brantemadara-spec/laps/dist/images/assembled.webp

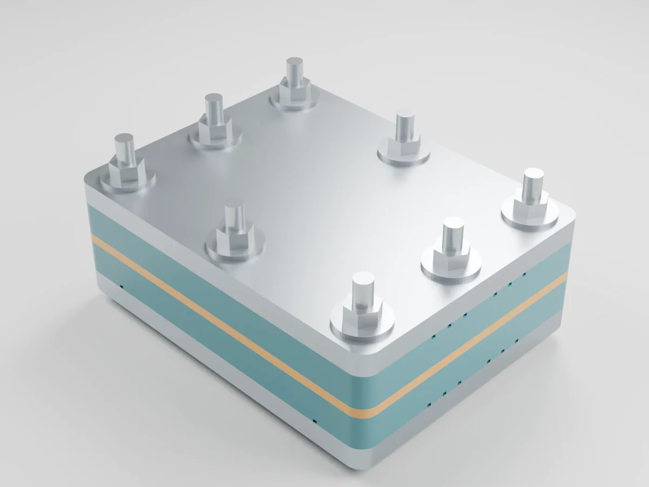
dist/images/assembled.webp
