brantemadara-spec/laps/assets/marle_source/visual/renders/01_assembled_45deg.png

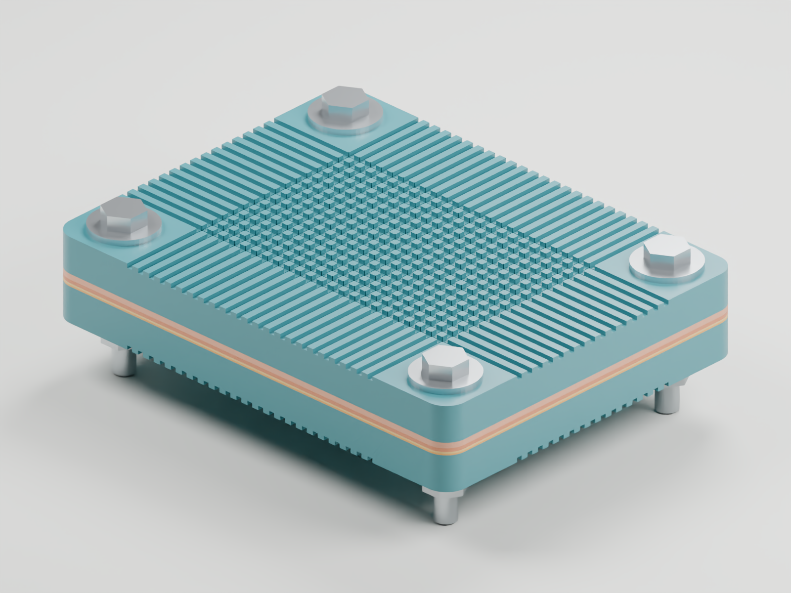
assets/marle_source/visual/renders/01_assembled_45deg.png
