brantemadara-spec/laps/dist/files/LAPS_Pirkumu_saraksts_DEPO_Bergi.pdf

LAPS · DEPO Berģi · cenu pārbaude 2026-10-06 | 1

# LAPS — pirkumu saraksts

DEPO Berģi · Siguldas šoseja 6 · 6. oktobris 2026

DEPO Berģu aktuālās cenas un atlikumus nevarēju tieši apstiprināt. DEPO summas ir sekundāras cenu salīdzinātāja norādes. Citu veikalu piedāvājumi ir alternatīvas, ja vajadzīgo DEPO nevar sagādāt. Pilnam budžetam trūkst plākšņu un sieta tāmes.

# 1. Pamatvariants esošajam 3D modelim

Prece /
daudzums
Precīzs izmērs | Cena un iegādes vieta
8 bultskrūves | M6 × 60; pilna vītne DIN 933; solis 1,0; vēlama klase 8.8 | DEPO cena nav apstiprināta. Delve 2 alternatīva: 10.9 melnas, 10 gab.; 1,36 € ar aprēķinātu 21% PVN.
8 uzgriežņi | M6 DIN 934; atslēga 10 mm; atbilstoša klase | DEPO salīdzinātāja norāde: 100 gab., klase 12.0; 2,11 €.
16 paplāksnes | M6 DIN 9021; Ø6,4 × Ø18 × 1,6; metāla, bez gumijas | DEPO salīdzinātāja norāde: 40 nerūsējošas; 2,62 €.
2 tērauda plāksnes | S235; 130 × 100 × 8; R6; 8 × Ø6,6 katrā | DEPO cena nav apstiprināta. Metāla Alianse: gatavās detaļas pēc tāmes.
2 sieta oderes | 84,5 × 54,5, R3; 304; acs 0,15; stieple 0,10 mm | DEPO cena nav apstiprināta. EuroSitex: maza atgriezuma un markas tāme.
1 PETG spole | Ø1,75 mm; 1 kg; bez CF pildījuma | DEPO cena nav apstiprināta. Filaments.lv eSUN PETG Basic: 14,90 € ar PVN; pakomāts +2,90 €.

Atsauces daļsumma 20,99 € = 1,36 + 2,11 + 2,62 + 14,90. Tā apvieno citu veikalu cenas un neapstiprinātas DEPO norādes. Vēl jāpieskaita gatavās plāksnes, siets, izvēlētā piegāde un rīki. Tā nav visa projekta gala cena.

Delve 2 publiskais iepakojums: 93310M-6X60, 10 gab., 1,12 € bez PVN; ×1,21 → 1,36 €. Atlikums un piegāde nav apstiprināti. Ja DEPO ir vajadzīgās cinkotās 8.8 skrūves, izmanto tās šīs alternatīvas vietā. Melno skrūvju virsmas pēc mitras lietošanas nosusina.

Nepirkt gremdgalvas skrūves, kokskrūves vai daļējas vītnes skrūves, nepārbaudot derīgumu visiem pieciem gredzeniem. Skrūves garumu 60 mm mēra zem galvas.

# 2. Izvēles DEPO vītņstieņa variants

Šis variants aizstāj 8 bultskrūves un 8 uzgriežņus. Paplāksnes paliek 16. Vienu variantu izvēlas visam komplektam; abus nepērk kopā. Modelī un renderos attēlotas oriģinālās 60 mm skrūves.

Pirkt | Izmērs / izmantošana | Sekundāra DEPO norāde
1 vītņstienis | M6 × 1,0; A2; 1000 mm → 8 gab. pa 70 mm | 1,70 €; agrāk indeksēts, aktuālā cena nav apstiprināta.
1 uzgriežņu iep. | M6 DIN 934, nerūsējoši; 40 gab.; izmantot 24 | 2,37 €; Berģu cena un atlikums nav apstiprināti.
1 paplāksņu iep. | M6 DIN 9021, nerūsējošas; 40 gab.; izmantot 16 | 2,62 €; Berģu cena un atlikums nav apstiprināti.

Stiprinājumu atsauces daļsumma 6,69 €; ar PETG 21,59 €. Plāksnes, siets, piegāde un rīki nav iekļauti. Daļsumma ietver agrāk indeksēto vītņstieņa cenu un nav apstiprināts DEPO piedāvājums.

Salikšana

Apakšā uz katra stieņa ir divi savstarpēji nofiksēti uzgriežņi; iekšējais balstās uz paplāksnes pret tērauda plāksni. Augšā ir viena paplāksne un viens uzgrieznis. Apakšējos uzgriežņus savstarpēji noslēdz ar divām atslēgām pirms celulozes pildīšanas. Stieņu grieztos galus novīlē un pārbauda vītnes.

Lielākā komplekta nominālais biezums: 24 + 16 + 5,4 = 45,4 mm. Ar paplāksnēm un trim apmēram 5–5,2 mm uzgriežņiem kopā 63,6–64,2 mm. 70 mm stienis dod vietu vītnes izvirzījumam abos galos; faktisko izmēru pārbauda saliekot. Aizver pakāpeniski pa diagonāli, saudzīgi ar roku. Uzgriežņu pievilkšana nav spiediena mērījums.

Rīki — aizņemties, pirkt tikai trūkstošos

Vajag | Alternatīva, ja DEPO nevar sagādāt | Cena bez piegādes
2 atslēgas 10 mm | REVA CR-V SATIN SA-6314324 | 2 × 1,22 = 2,44 €
1 bīdmērs 0–150 mm | REVA metāla EK-3015 | 5,00 €
1 svari 200 g / 0,01 g | Motivs, kods 132772 | 6,60 €

Rīku kopā 14,04 € pirms piegādes. REVA publicē pieejamību; Motivs publicē 10+, bezmaksas saņemšanu Duntes 56 un pakomātu no 1,90 €. DEPO rīku cenas nav apstiprinātas. Rādījuma solis nav precizitātes garantija.

Izmantot esošu paplāti ≥200 × 150 mm, trauku, masas blenderi/maisītāju un žāvēšanas papīru. Vītņstienim vajag metāla zāģi un vīli. Ja drukas caurumus jāattīra: Ø2 un Ø6,6 mm urbji. Tērauda plāksnes vēlams saņemt jau izgatavotas.

# 3. Plākšņu un sieta izgatavošanas prasības

Tērauda atbalsta plāksnes

2 × S235/S235JR, 130 × 100 × 8 mm, ārējie stūri R6, gludas un plakanas saskares virsmas, visas malas un caurumi bez atskabargām. Katrai 8 caurejoši Ø6,6 mm urbumi bez vītnes. Vienas detaļas masa aptuveni 0,80 kg.

Centri no plāksnes centra, mm | Centri no plāksnes centra, mm
(−53, −38) (0, −38) (53, −38) | (−53, 0) (53, 0)
(−53, 38) (0, 38) (53, 38) | Visu urbumu Ø6,6; detaļas biezums 8 mm

Metāla Alianse: S235 8 mm loksne HRS00076, publiski 90 €/m² un noliktavā; PVN režīms izvilkumā nav skaidrs. 0,026 m² × 90 = 2,34 € ir tikai teorētiska sagatavju laukuma vērtība. Gatavu detaļu cena ietver darba minimumu, griešanu, 16 urbumus, atskabargu noņemšanu un vajadzīgo plakanumu. Nepieciešama tāme ar PVN un piegādi. Pilna 1500 × 6000 mm loksne šim projektam nav vajadzīga, ja piegādātājs izgatavo no sava materiāla.

Metāla Alianse — S235 loksne 8 mm, HRS00076 (https://www.metali.lv/lv/produkti/loksne-karsti-velmeta/8mm-1500x6000)

Metāla Alianse — detaļu griešana un urbšana (https://www.metali.lv/lv/pakalpojumi)

Smalkais siets

Vēlams 304 / 1.4301, vienkārša pinuma siets: acs 0,15 mm (150 µm), stieple 0,10 mm, apmēram 100 mesh. Pasūtāma viena 200 × 150 mm sagatave; no tās izgriež četrus 84,5 × 54,5 mm R3 gabalus, divi ir rezerves. Minimāli 150 × 100 mm sagatave dod divus gabalus.

EuroSitex Latvija piedāvā tehnisko nerūsējošo sietu, bet publiski norāda garumu no 1 m. Precīzās markas atlikums un maza atgriezuma/parauga iespēja jānoskaidro. getwiremesh EU alternatīvai publicēta formula 34 €/m² + 6 € par griezumu: 200 × 150 mm aritmētiski 7,02 € pirms PVN un piegādes. Konkrētā izmēra pieņemšana, atlikums un Latvijas piegādes cena nav apstiprināti. Tas nav gala piedāvājums.

EuroSitex Latvija — nerūsējošais tehniskais siets (https://eurositex.lv/lv/Produkcija/stieples-siets--tehniskais-audums-%28stieple-lidz-1_4-mm%29/16/nerusejosie-stieplu-sieti/78/)

getwiremesh — 0,15 mm acs / 0,10 mm stieple (https://getwiremesh.com/shop/wiremesh-v2a-1501/)

Parasts moskītu siets nav automātisks aizvietotājs. Izmēra saspiesto sieta biezumu. Gredzeni paredz 2 × 0,20 mm; citam sietam faktiskā celulozes sprauga jāpārkalibrē.

Izgatavotājam dotie faili

P03_steel_backer_8mm_1to1.dxf · steel_backer_MAKE_2.step · LAPS_Pulp_Press_Technical_Drawings_RevA.pdf
- P04_mesh_cut_pattern_1to1.dxf · Tames_pieprasijumi_LV.txt. Pirkumu arhīvā tie ir jau pievienoti. Pieprasījuma teksts ir sagatavots, nav nosūtīts.

Ko drukāt

2 PETG plāksnes un pa vienam no pieciem gredzeniem, augstumi 1,4 / 2,4 / 3,4 / 4,4 / 5,4 mm. Gredzens nosaka 1–5 mm mitro spraugu, nevis garantētu sauso biezumu. Visu izdruku CAD masa apmēram 549 g; viena 1 kg spole dod rezervi. eSUN profilam izmanto eSUN ražotāja parametrus.

# 4. Avoti un budžeta aizpildīšana

Pārbaudīts 2026. gada 6. oktobrī. Veikalu publicētie atlikumi nav rezervācija. Neviena alternatīvā veikala lapa neapliecina DEPO Berģu pieejamību.

DEPO veikalu saraksts — Berģi, Siguldas šoseja 6 (https://depo.lv/)

DEPO cenu norādes — sekundārs avots

DEPO uzgriežņu ieraksts cenu salīdzinātājā (https://www.salidzini.lv/click.php?itemid=95754468776&q=uzgrieznis+din+934m-6) — 100 gab.; 2,11 €; Berģu cena nav apstiprināta

DEPO paplāksņu ieraksts cenu salīdzinātājā (https://www.salidzini.lv/click.php?itemid=95755187871&q=papl%C4%81ksnes+din9021+m6) — 40 gab.; 2,62 €; Berģu cena nav apstiprināta

DEPO M6 A2 vītņstieņa cenu salīdzinātāja ieraksti (https://www.salidzini.lv/click.php?itemid=95609168596) — 1000 mm M6 A2; 1,70 € ir agrāk indeksēta norāde

DEPO nerūsējošo M6 uzgriežņu 40 gab. ieraksti (https://www.salidzini.lv/click.php?itemid=95753564220) — 40 gab.; 2,37 €; Berģu cena nav apstiprināta

Citu veikalu pārbaudītās produktu lapas

Delve 2 — DIN 933 pilnas vītnes skrūves, melnas (https://www.delve2.lv/lv/products/screws-with-metric-thread/hexagon-head-bolts-full-thread-black-din-933m/) — 10 gab. M6 × 60, klase 10.9; 1,12 € bez PVN

Filaments.lv — eSUN PETG Basic melns, 1 kg (https://filaments.lv/produkti/esun-petg-basic-melns-filaments-black/) — 14,90 € ar PVN; pakomāts +2,90 €; publicēti 25 gab.

REVA — 10 mm kombinētā atslēga (https://www.reva.lv/sa-6314324-kombineta-atslega-10-mm-cr-v-satin-%28indija%29/1840/1/p) — 1,22 €/gab. ar PVN; vajag 2

REVA — 150 mm metāla bīdmērs (https://www.reva.lv/ek-3015-bidmers-150mm-002mm/1061/1/p) — 5,00 € ar PVN

Motivs — 200 g / 0,01 g svari, 132772 (https://motivs.lv/kabatas-un-juvelierizstradajumu-svari/elektroniskie-juvelierizstradajumu-svari-200g-0-01g-sudraba) — 6,60 €; pakomāts no 1,90 €

Darba faili

LAPS_Pirkumu_budzets.xlsx: zilajās šūnās ievada apstiprināto cenu par iepakojumu. Var labot pērkamo iepakojumu skaitu. Rindu gala summa parādās tikai, kad visas attiecīgā varianta cenas aizpildītas. Nezināmās cenas ir tukšas, nevis 0 €.

LAPS_Pirkumu_saraksts.csv ir vienkārša tabula; Markdown versijā ir plašāki paskaidrojumi. Tāmes teksts un CAD faili ir atsevišķajā pirkumu ZIP un atjaunotajā pilnajā projekta ZIP.

Pamatvariants: atsauces daļsumma 20,99 € + gatavo plākšņu tāme + sieta tāme + izvēlētā piegāde. Vītņstienis: atsauces daļsumma ar PETG 21,59 € + tie paši iztrūkstošie izdevumi. Izvēles rīki 14,04 € pirms piegādes. Gala budžets pašlaik nav apstiprināts.

Skrūvju klase un paplāksnes nerada zināmu celulozes spiedienu. Formas aizvēršanai lieto roku spēku; spiediena pētījumos izmanto skolas izmērīta spēka presi un projekta eksperimentu rokasgrāmatu.
