brantemadara-spec/laps/assets/marle_source/procurement/LAPS_Marle_Iepirkums_DEPO_Bergi_LV.pdf

LAPS Marle · Rev C · cenas pārbaudītas 07.10.2026. | 1

# LAPS Marle

## Rev C · jaunais pirkumu saraksts

Četri stūra stiprinājumi, noņemams vāks, divas 10 mm PETG plāksnes un kokvilnas marle kartītes abās pusēs. Šis saraksts aizstāj iepriekšējā sieta/eņģes varianta iepirkumu.

Prioritāte: DEPO Berģi, Siguldas šoseja 6. Oficiālā veikala adrese. (https://depo.lv/) Cenas pārbaudītas 2026. gada 7. oktobrī.

Kas jāņem | Daudzums | Precīza specifikācija
Pilnas vītnes metāla skrūve | 4 gab. | M6 × 40 mm, solis 1,0 mm; DIN 933 / ISO 4017; sešstūra galva. Cinkots 8.8 vai atbilstošs nerūsējošs variants.
Sešstūra uzgrieznis | 4 gab. | M6, solis 1,0 mm, DIN 934; 10 mm atslēga.
Platā metāla paplāksne | 8 gab. | M6 DIN 9021; Ø6,4 / Ø18 × 1,6 mm; pa vienai zem katras galvas un uzgriežņa. Bez gumijas.
Parasta kokvilnas marle | 1 iepakojums | 100% kokvilna, neimpregnēta; piem., 90 cm × 1 m. Izgriež 2 loksnes 84,5 × 54,5 mm, R3; pa vienai gludai kārtai katrā pusē.
PETG filaments, ja vajadzīgs | 1 spole | Ø1,75 mm, 1 kg; parasts PETG bez CF pildījuma. Esošo piemēroto materiālu var izmantot.

## Kas no iepriekšējā saraksta izņemts

Divas tērauda atbalsta plāksnes; visa eņģe un tās M4 stiprinājumi; smalkais poliestera siets. M6×60 skrūves jaunpirkumā aizstātas ar M6×40. M6 uzgriežņus, platās paplāksnes un piemērotu PETG var izmantot no esošā komplekta.

DEPO cena un Berģu atlikums nav apstiprināti. DEPO Online pārlūkošanas pārbaudē neatdeva nolasāmu produktu katalogu. Tas nenozīmē, ka preču veikalā nav. Veikalā jāmeklē tieši tabulā dotie izmēri, un pirkuma cena jāieraksta čekā balstītajā projekta tāmē.

# Pārbaudītas cenu alternatīvas

Izmanto, ja vajadzīgo preci nevar iegādāties DEPO. Šīs ir citu pārdevēju interneta cenas, un tās neapliecina DEPO Berģu cenu vai krājumu. Piegāde nav iekļauta. Nepērk vairākus alternatīvos skrūvju komplektus vienlaikus.

Pārdevējs / detaļa | Iepakojums un pirkuma cena | Vajadzīgo detaļu vērtība
Delve 2: M6×40 A2 DIN 933 933A2-6X40 | 20 gab.; 2,60 € bez PVN → 3,15 € ar 21% PVN | 4 gab. ≈ 0,63 €
Delve 2: M6×40 8.8 ZN DIN 933 FOR-933-6X40 | 200 gab.; 12,80 € bez PVN → 15,49 € ar 21% PVN | 4 gab. ≈ 0,31 €
Delve 2: M6×40 10.9 melna DIN 933 93310M-6X40 | 10 gab.; 0,88 € bez PVN → 1,06 € ar 21% PVN | 4 gab. ≈ 0,43 €
INSERV: M6 DIN 934 ESSVE 61068525 | 100 gab.; 4,40 € ar PVN | 4 gab. ≈ 0,18 €
INSERV: M6 DIN 9021 ESSVE 61068297 | 100 gab.; 4,70 € ar PVN | 8 gab. ≈ 0,38 €
BENU: MEDRULL marle 100% kokvilna, 90 cm × 1 m | 1 iep.; 1,09 € attēlotā cena | Formai 2 izgriezumi; atlikums turpmākiem testiem
Filaments.lv: eSUN PETG Basic Ø1,75 mm, 1 kg, melns | 1 spole; 14,90 € ar PVN | Galīgais patēriņš pēc slicera; esošo spoli var lietot

Cena par vajadzīgo skaitu ir materiālu patēriņa vērtība, nevis summa, par kuru var nopirkt iepakojumu. Piemēram, četri A2 stiprinājumi patērē ap 0,63 €, bet pārdevēja 20 gabalu iepakojums maksā aprēķinātos 3,15 €.

Vienas izvēles piemērs: A2 skrūvju iepakojums + INSERV uzgriežņu un paplāksņu iepakojumi + BENU marle = 13,34 € par pilniem iepakojumiem, pirms piegādes. Ja vajadzīga arī jauna PETG spole, šo pašu iepakojumu summa ir 28,24 €. Tā nav DEPO tāme vai viena veikala pirkums.

Delve 2 precīzs noliktavas atlikums nav publicēts; tā noteikumi nosaka cenu bez PVN, šeit gala summa aprēķināta ar 21%. INSERV abiem produktiem norādītas 5 darba dienas, nevis tūlītējs atlikums. BENU piedāvā pirkšanu internetā; konkrētas aptiekas krājums nav verificēts. Filaments.lv produkta lapā norādīti 25 gab. uz vietas; pakomāts Latvijā 2,90 €, saņemšana Kalnciema ielā 148 bez maksas.

# Izmēri, marle un avoti

## Kāpēc jaunā skrūve ir M6×40

Maksimālais salikums no skrūves galvas līdz uzgriežņa ārpusei: 2 × 10 mm PETG + 5 mm starpliku summa + 0,8 mm kalibrācijas pamatstarplika + 2 × 1,6 mm paplāksnes + 5,2 mm uzgrieznis = 34,2 mm. M6×40 dod 5,8 mm vītnes izvirzījumu; garumu mēra zem galvas. 35 mm nav universālais izmērs šim maksimālajam salikumam.

## Marle maina biezuma kalibrāciju

Medicīniskā marle ir lēts izmēģinājuma audums, nevis precīzs 100–200 µm filtrs. Tās atvērumi un šķiedru aizturēšana jāpārbauda ar īsto papīra/lapu masu. Pirms darba marli izskalo tīrā ūdenī un novieto vienā gludā, nesalocītā kārtā. Brīvas apgrieztās šķiedras noņem, nelīmējot un neapšujot malu preses spraugā.

Modelī izmantotais 0,2 mm saspiestais marles biezums katrā pusē ir pieņēmums. Izmēra abas samitrinātās un saspiestās loksnes kopā. Izvēlas vienu pamatstarpliku 0,2 / 0,4 / 0,6 / 0,8 mm, kas atbilst izmērītajai auduma summai, un pievieno vēlamo mitrās masas starpliku summu. Formulas: mitrā sprauga = visu starpliku biezums − abu marļu saspiestais biezums. Pamatstarplikas nesakrauj kā četras obligātas detaļas.

## Nemainīgi nepieciešamās lietas

Divas 10 mm atslēgas, bīdmērs vai skolas mikrometrs, šķēres, ūdens savākšanas paplāte un svari izmēģinājumiem. Izmanto esošos rīkus vai aizņemies skolā. Plānāks PETG salikums bez tērauda nav validēta augstas slodzes prese; paplāksnes izkliedē tikai vietējo skrūvju slodzi. Pievilkšanas moments nenosaka masu nospiešanas spēku.

## Tiešie cenu un specifikāciju avoti

DEPO veikala adrese un Online (https://depo.lv/)

Delve 2 — M6×40 A2, 20 gab. (https://www.delve2.lv/lv/products/screws-with-metric-thread/hexagon-head-bolts-full-thread-stainless-steel-din-933ss/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)

Delve 2 — M6×40 8.8 ZN, 200 gab. (https://www.delve2.lv/lv/products/screws-with-metric-thread/hexagon-head-bolts-full-thread-zinc-palted-din-933zn/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)

Delve 2 — M6×40 10.9 melna, 10 gab. (https://www.delve2.lv/lv/products/screws-with-metric-thread/hexagon-head-bolts-full-thread-black-din-933m/)

Delve 2 — cenu PVN un krājumu noteikumi (https://www.delve2.lv/lv/info/terms-conditions/)

INSERV — M6 DIN934 uzgriežņi (https://www.inserv.lv/products/80791/din934-uzgrieznis-m6-fzb-100gab-essbox-61068525-essve)

INSERV — M6 DIN9021 6,4/18×1,6 (https://www.inserv.lv/products/80804/paplaksne-din9021-m6-fzb-100gab-essbox-61068297-essve)

INSERV — cenas ietver 21% PVN (https://www.inserv.lv/info/noteikumi)

BENU — MEDRULL marle 90 cm×1 m (https://www.benu.lv/p/medrull-marle-nesterila-90cmx1m)

Filaments.lv — eSUN PETG Basic 1 kg (https://filaments.lv/produkti/esun-petg-basic-melns-filaments-black/)

Iepriekš atrastās Salīdzini DEPO uzgriežņu un paplāksņu atsauces ir sekundāras. Atšķirīgas keša cenas neizmantoju kā DEPO tāmi; tās saglabātas tikai izpētes JSON. Pasūtījumi nav veikti, pārdevēji nav kontaktēti.
