brantemadara-spec/laps/PROJECT_DESTINATION.md

# LAPS project destination

Existing public Site: https://laps.dashulyaashsxb.chatgpt.site
Existing project ID: appgprj_6ac538346a088191976e30d51e90588b

This handoff is based on saved Site version 8, source commit
028185700c22cf091a5f689942a47965b97c4a25 (exported 2026-11-09).
The card press is Marle Rev C at / and /laps-siets/.
The pot mold is V4.1 at /podins/; Rev A is a historical archive at /arhivs/.

The local checkout path is not fixed. Serve dist/ as the web root.
Preserve the existing Site/URL for authorized future updates.
The hosting manifest is metadata, not a deployment credential. Access to the
existing Site must be granted by its owner through the hosting service.
No recurring update job is configured. This export does not change the live Site.

See README_SAKT_SEIT_LV.md and DEVELOPER_HANDOFF.md for development instructions.
The old destination note is retained in handoff/ for provenance.
