brantemadara-spec/laps/handoff/ORIGINAL_PROJECT_DESTINATION.md

# LAPS publication destination

Publish every authorized LAPS project update to the same existing Site:
- project_id: appgprj_6ac538346a088191976e30d51e90588b
- public URL: https://laps.dashulyaashsxb.chatgpt.site
- public label: laps
- source checkout: /workspace/laps-site
- current LAPS Marle Rev C at / and the preserved /laps-siets/ route
- pot prototype V4 Blender code, 9-part model and measured geometry review at /podins/; source uploaded 19.10.2026
- previous Rev A documents and design in the marked /arhivs/ archive

The user requested a permanent destination for all project changes; preserve this Site and URL. Do not create replacement Sites. This is a default for future edits, not a configured periodic background update.

Requested laps.zpd.chatgpt.site was rejected by Sites as a Sites-owned custom hostname. The workspace URL segment cannot be changed by the available Site tools. Shortened the same Site label to laps instead.
