brantemadara-spec/laps/dist/files/Laps.pdf

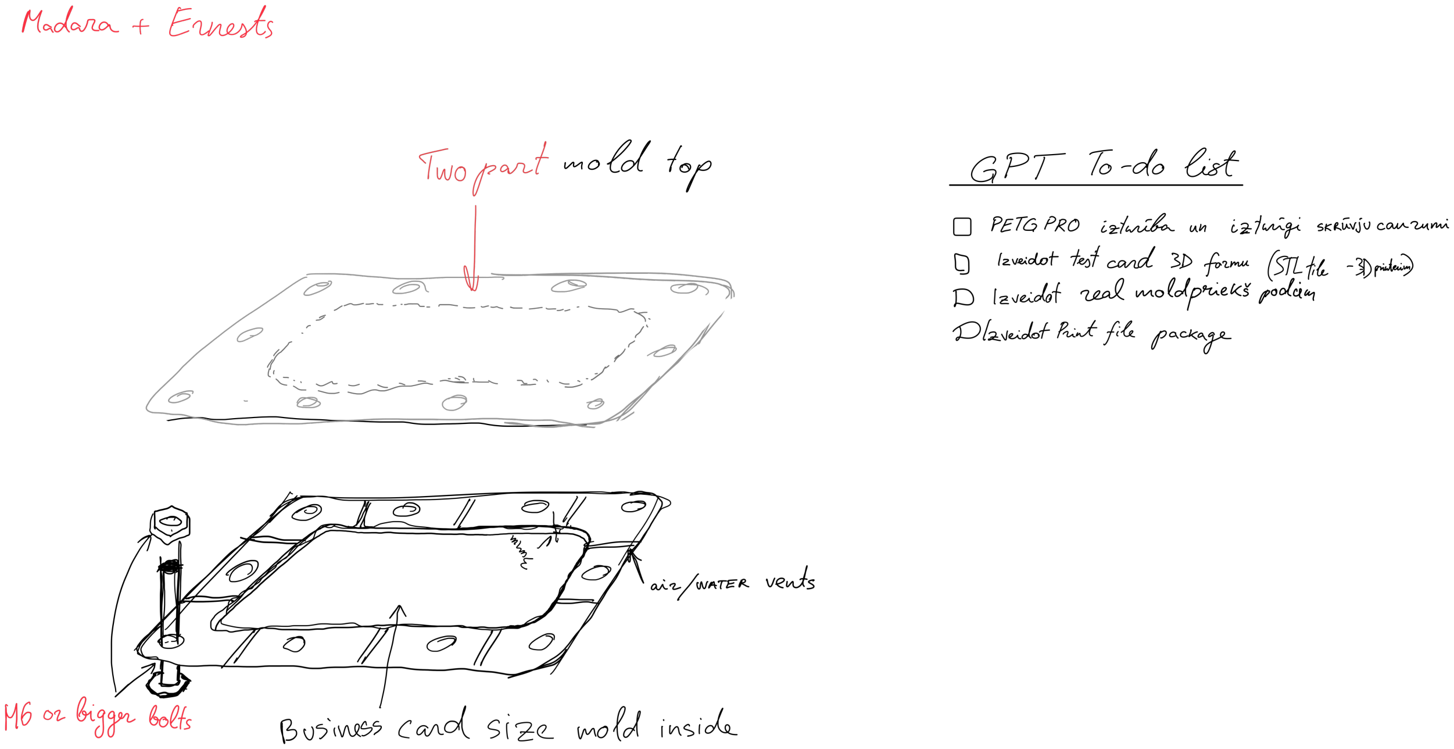
[picture p7: page 1]
