brantemadara-spec/laps/assets/marle_source/docs/web_pages/page-01.webp

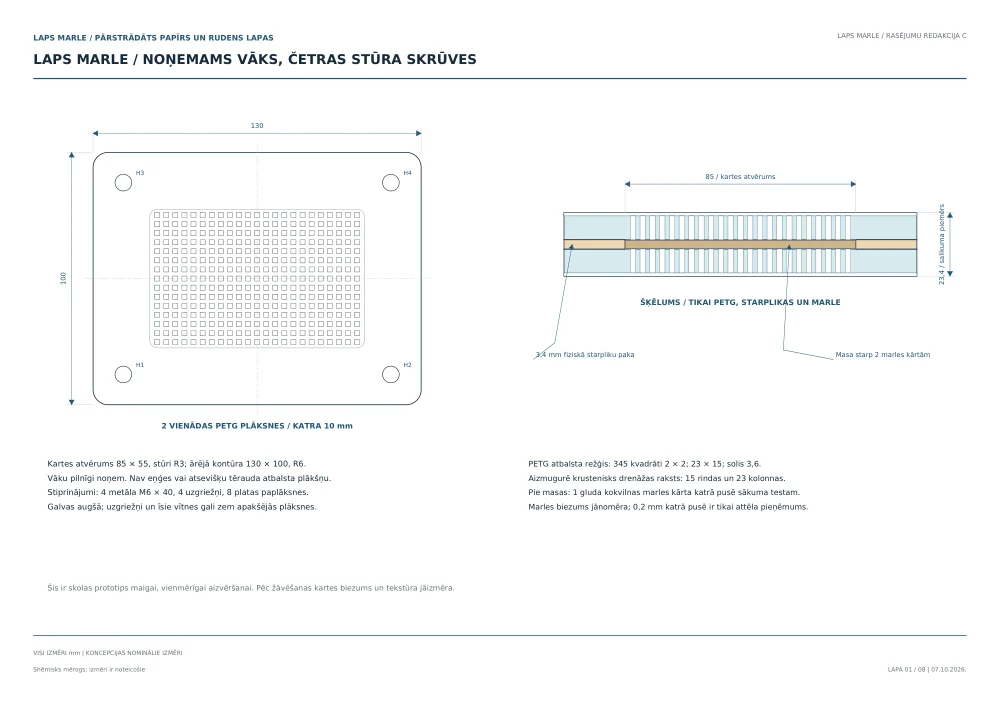
assets/marle_source/docs/web_pages/page-01.webp
