brantemadara-spec/laps/assets/marle_source/docs/web_pages/page-04.webp

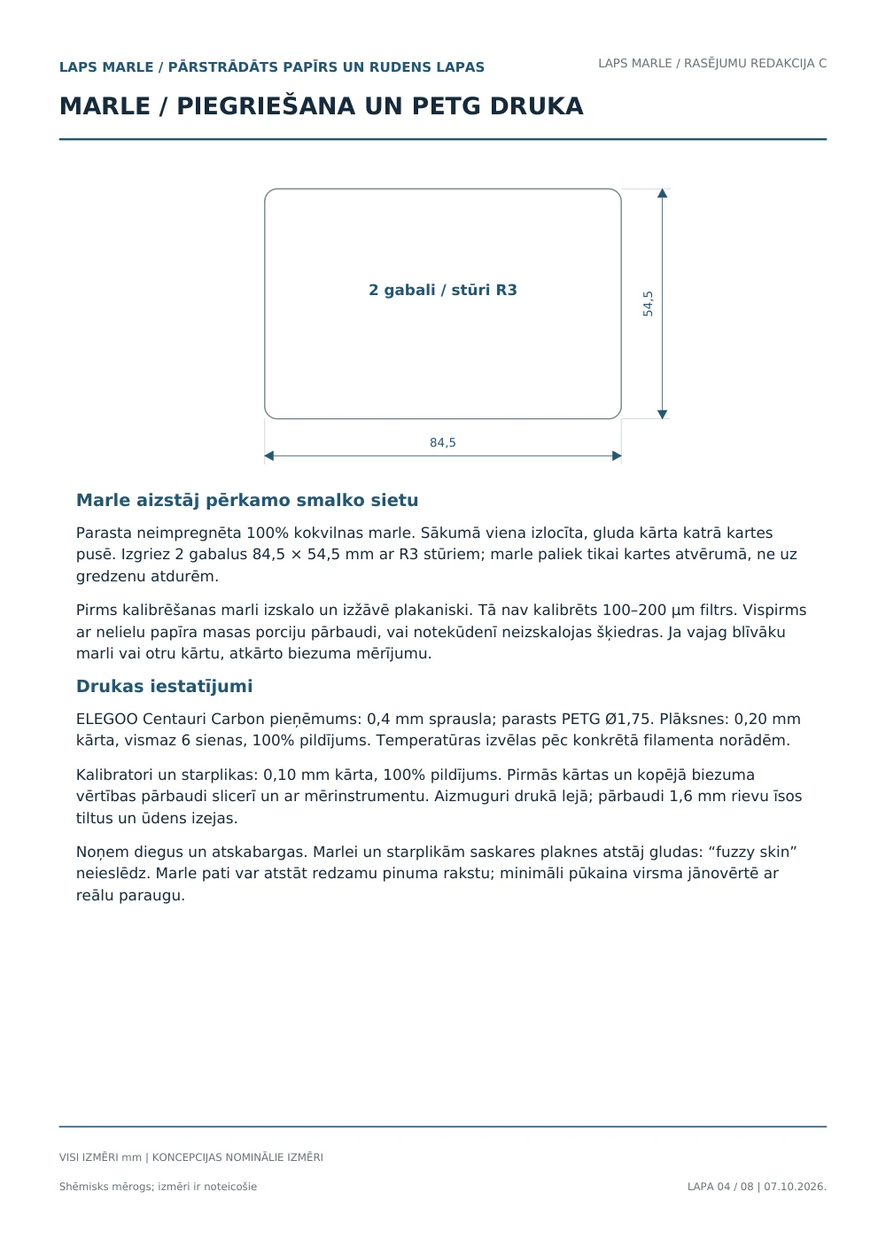
assets/marle_source/docs/web_pages/page-04.webp
