brantemadara-spec/laps/assets/marle_source/docs/web_pages/page-05.webp

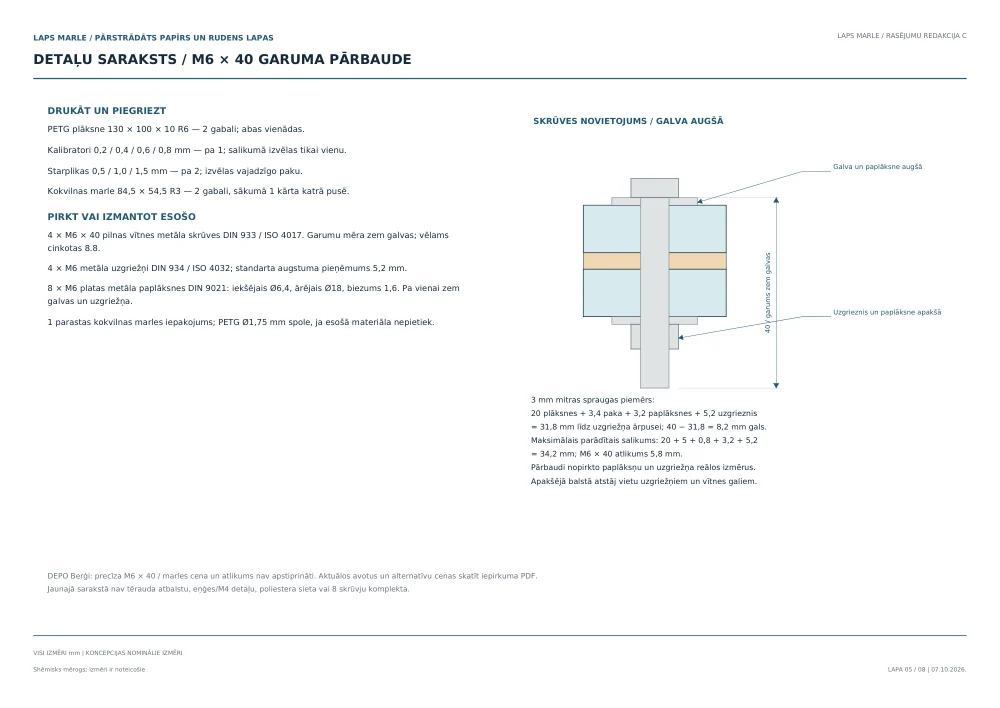
assets/marle_source/docs/web_pages/page-05.webp
