brantemadara-spec/laps/assets/marle_source/docs/web_pages/page-07.webp

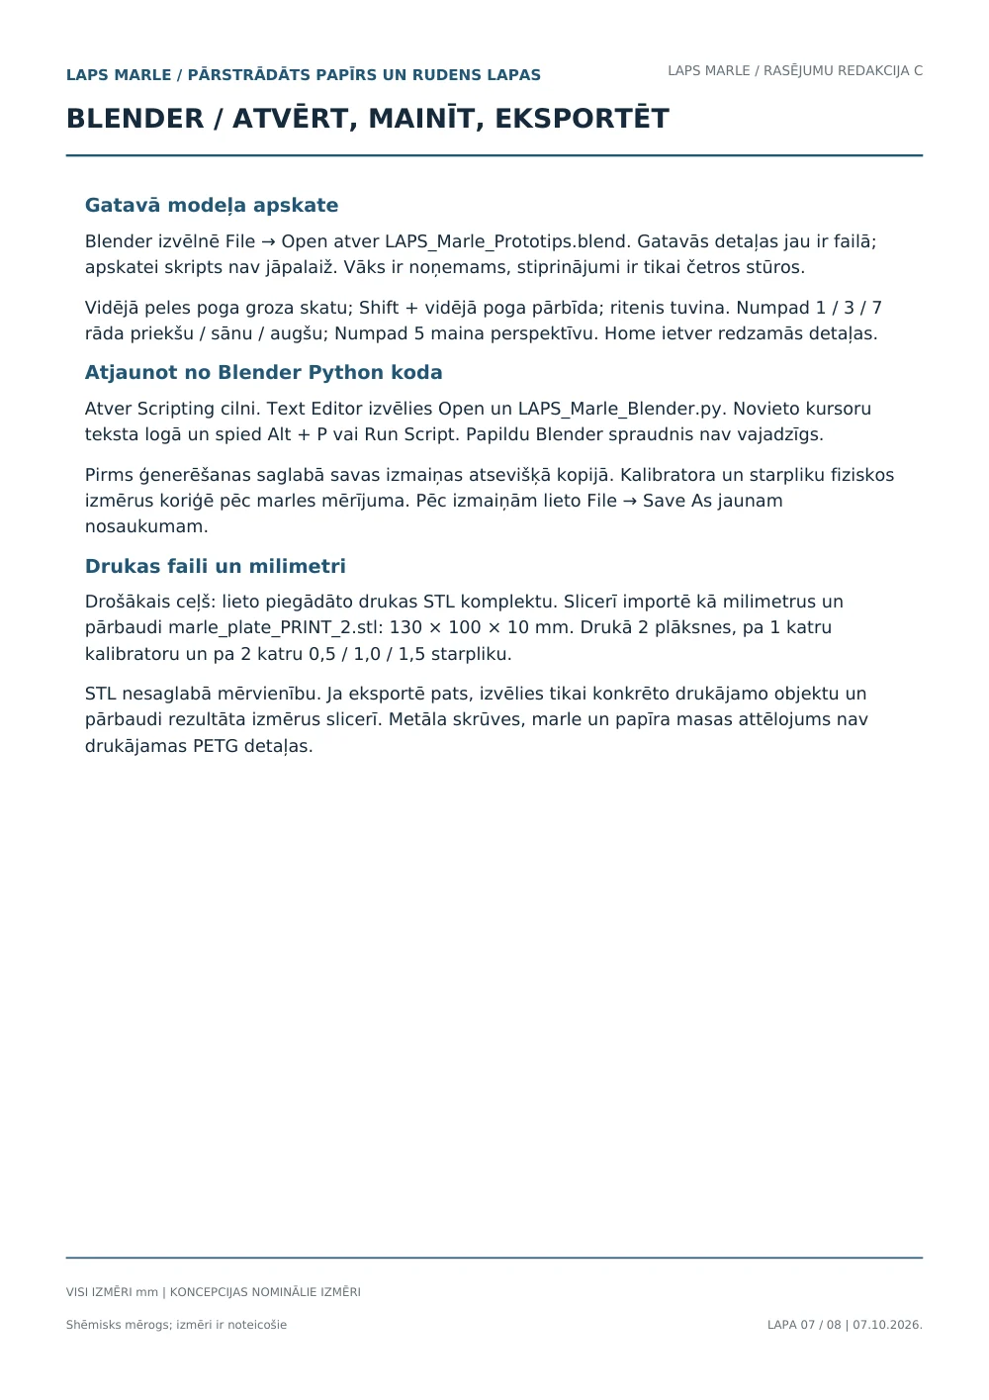
assets/marle_source/docs/web_pages/page-07.webp
