brantemadara-spec/laps/assets/marle_source/visual/renders/03_grid_and_gauze_detail.png

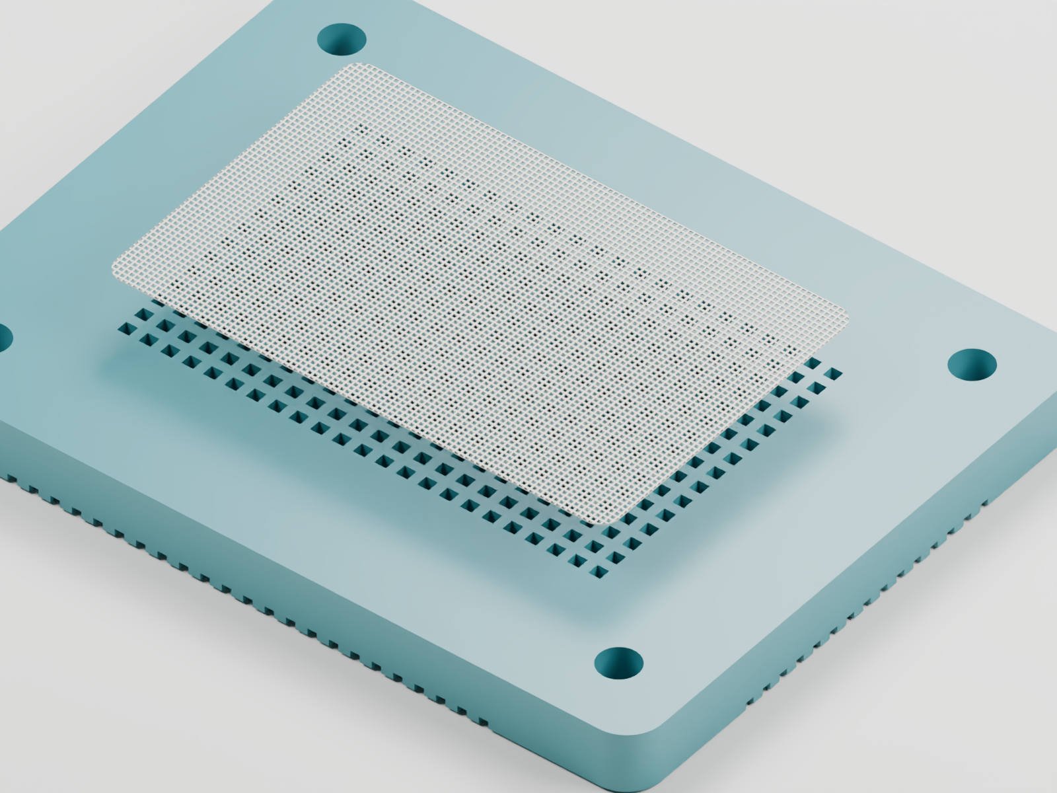
assets/marle_source/visual/renders/03_grid_and_gauze_detail.png
