brantemadara-spec/laps/dist/documents/pages/blender-01.webp

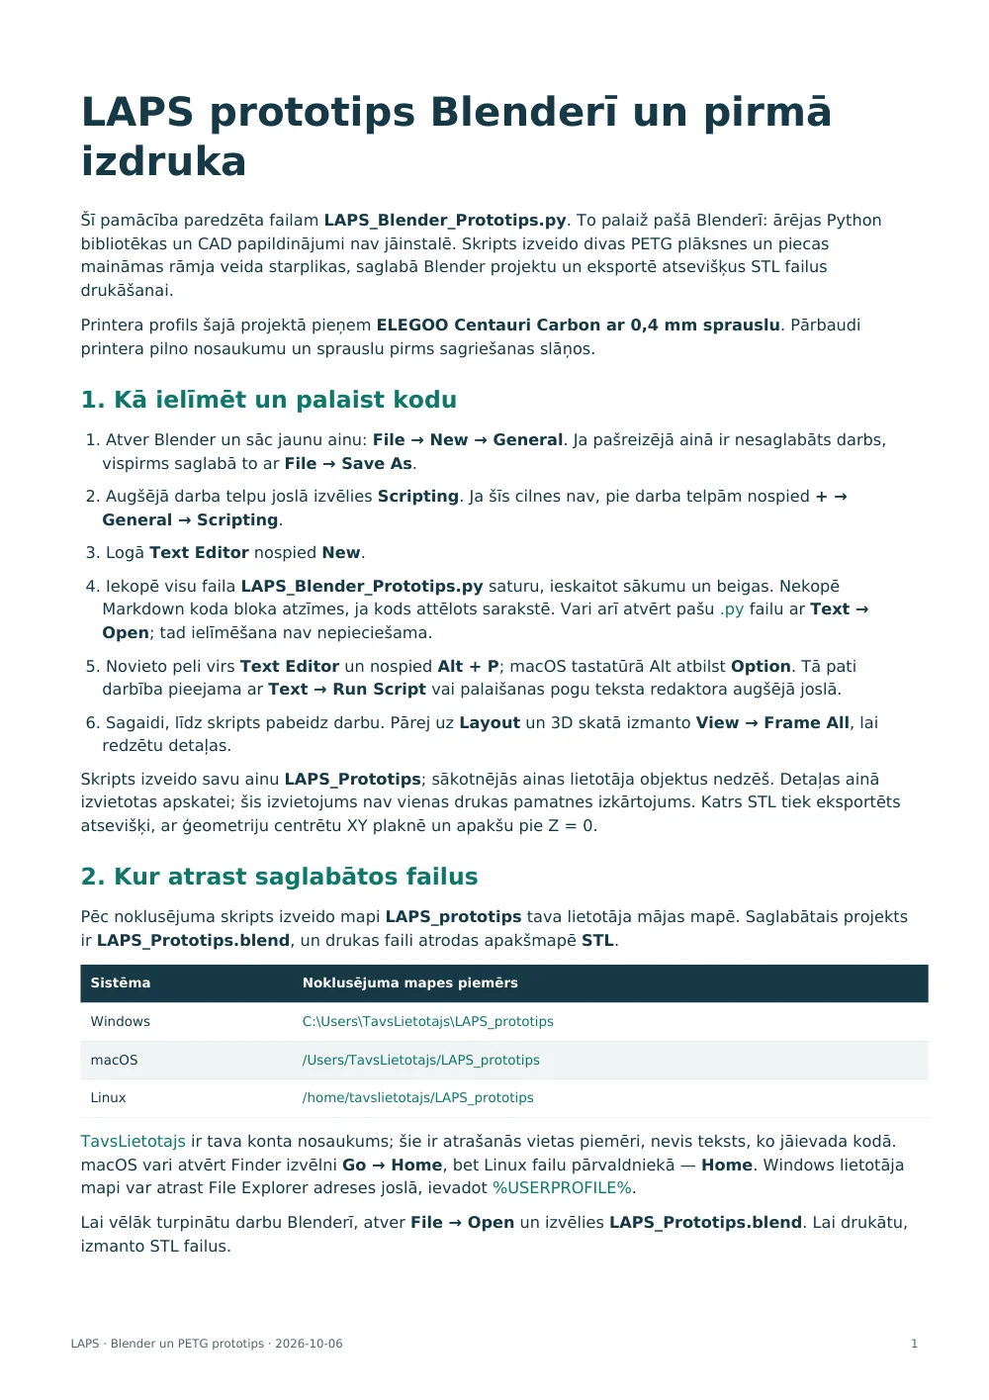
dist/documents/pages/blender-01.webp
