brantemadara-spec/laps/dist/documents/pages/blender-02.webp

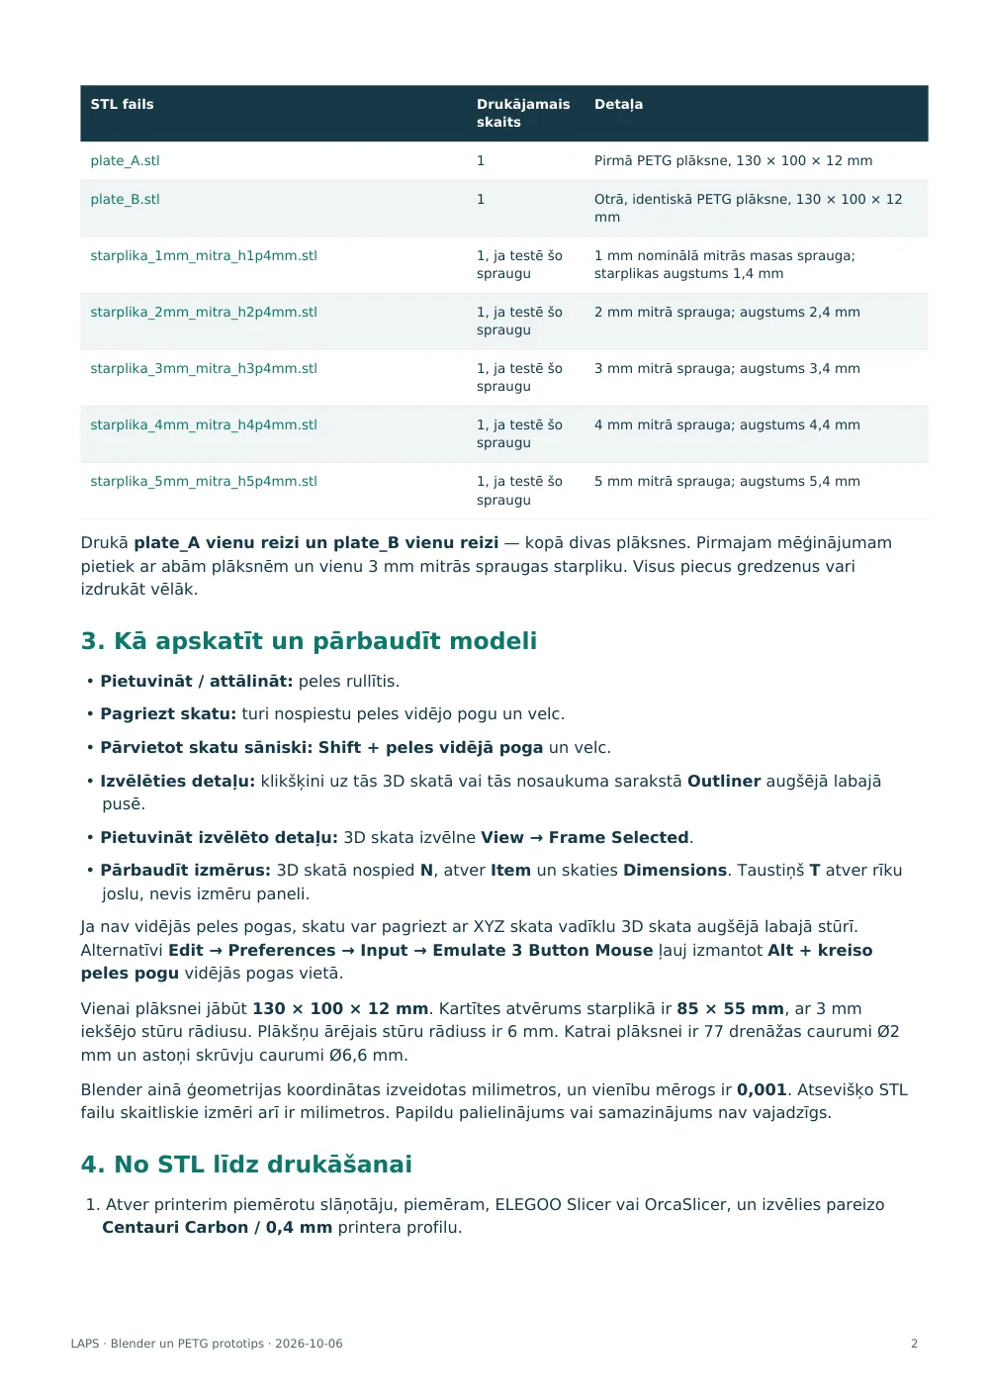
dist/documents/pages/blender-02.webp
