brantemadara-spec/laps/dist/documents/pages/blender-03.webp

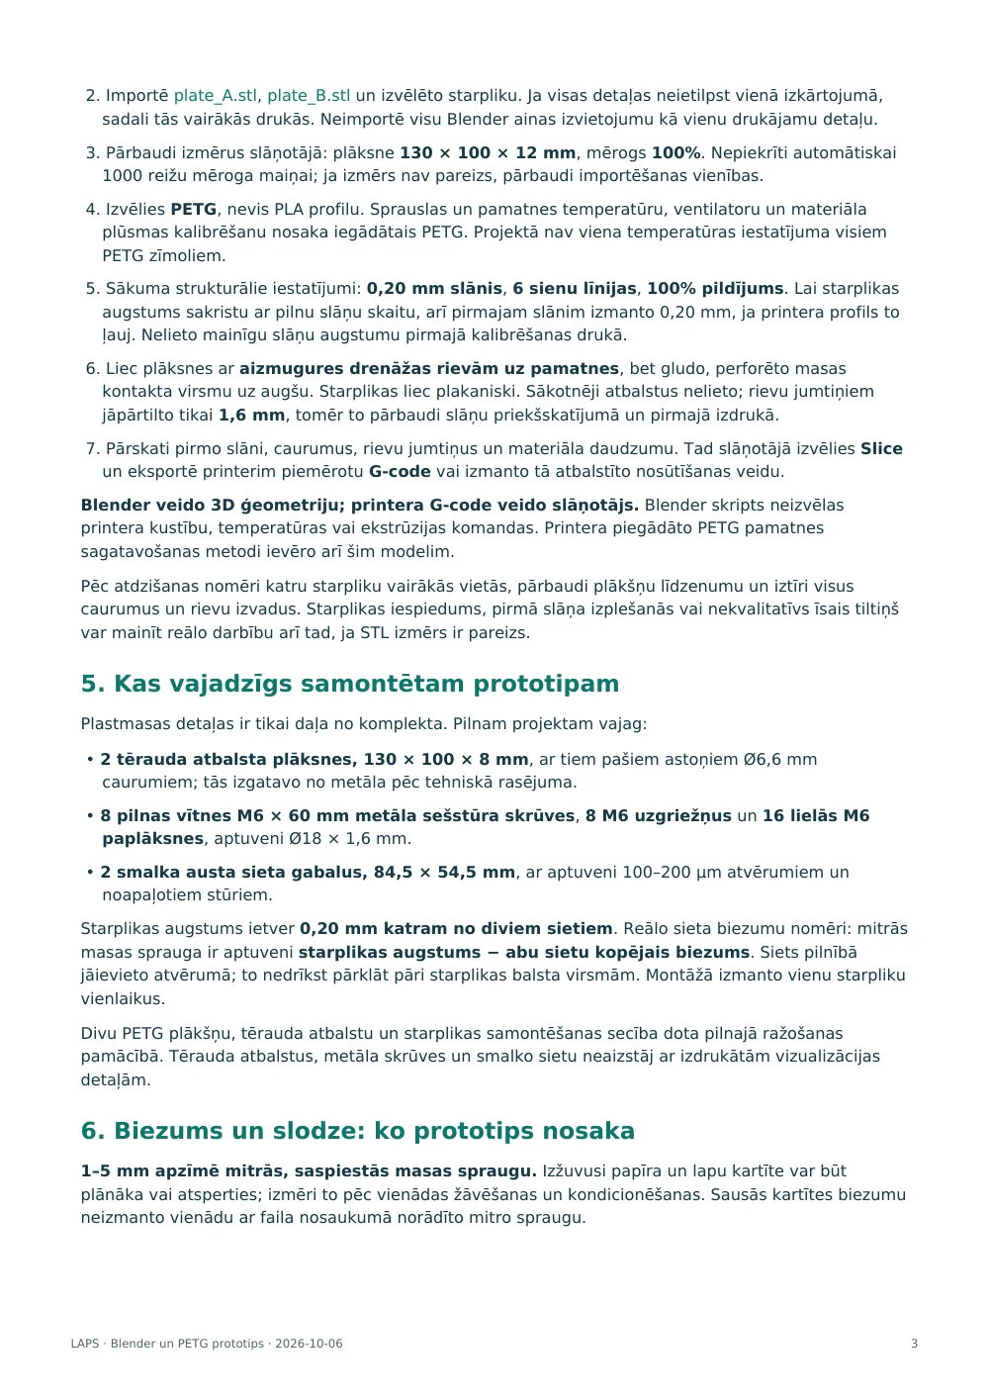
dist/documents/pages/blender-03.webp
