brantemadara-spec/laps/dist/documents/pages/blender-04.webp

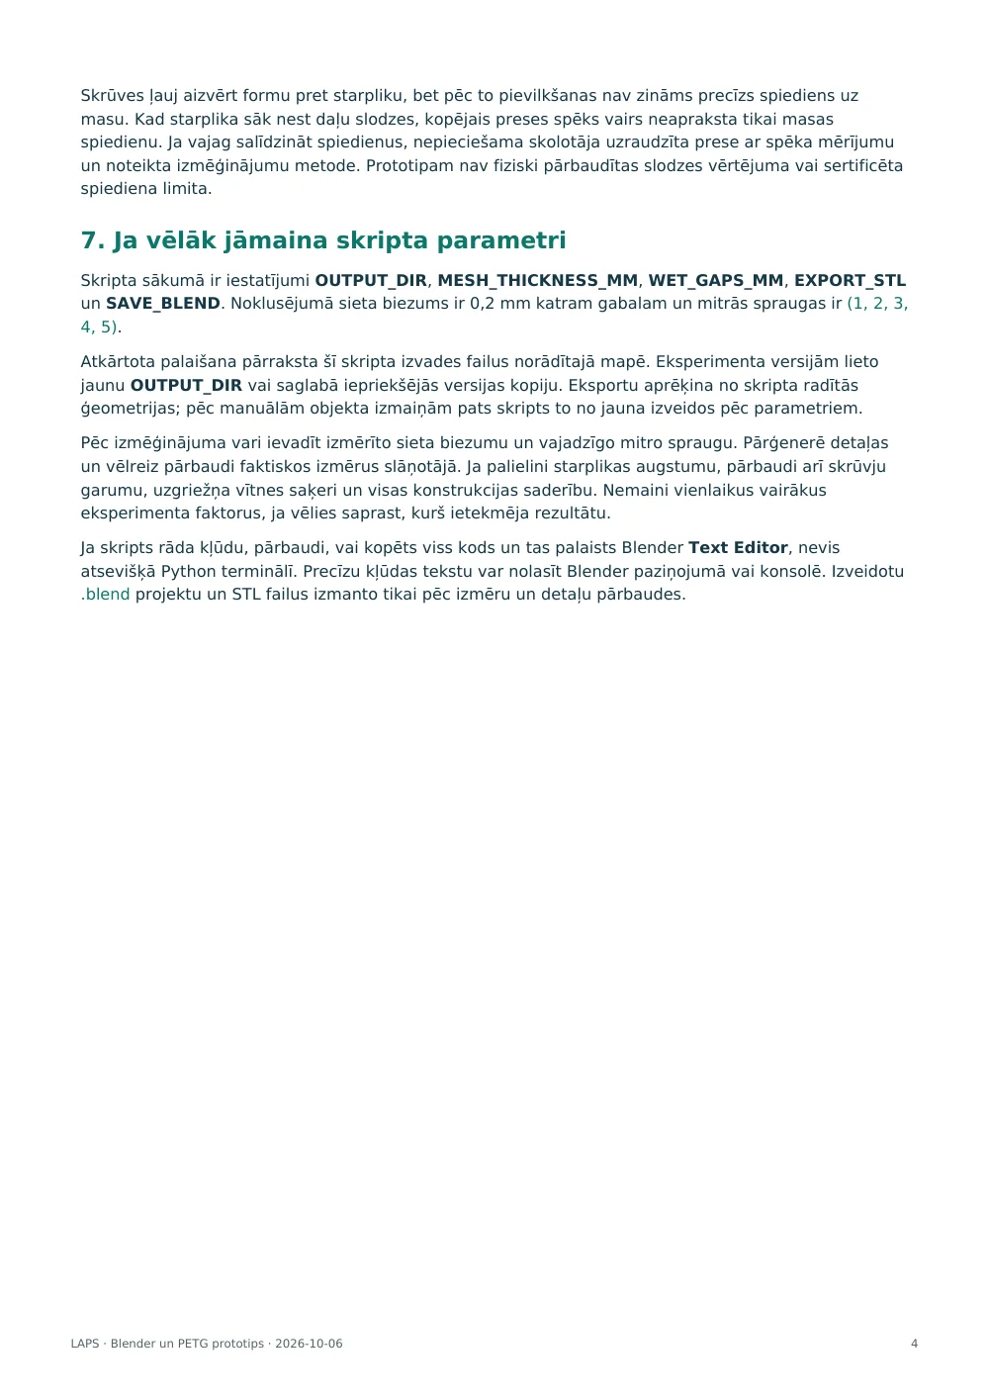
dist/documents/pages/blender-04.webp
