brantemadara-spec/laps/dist/documents/pages/iepirkums-01.webp

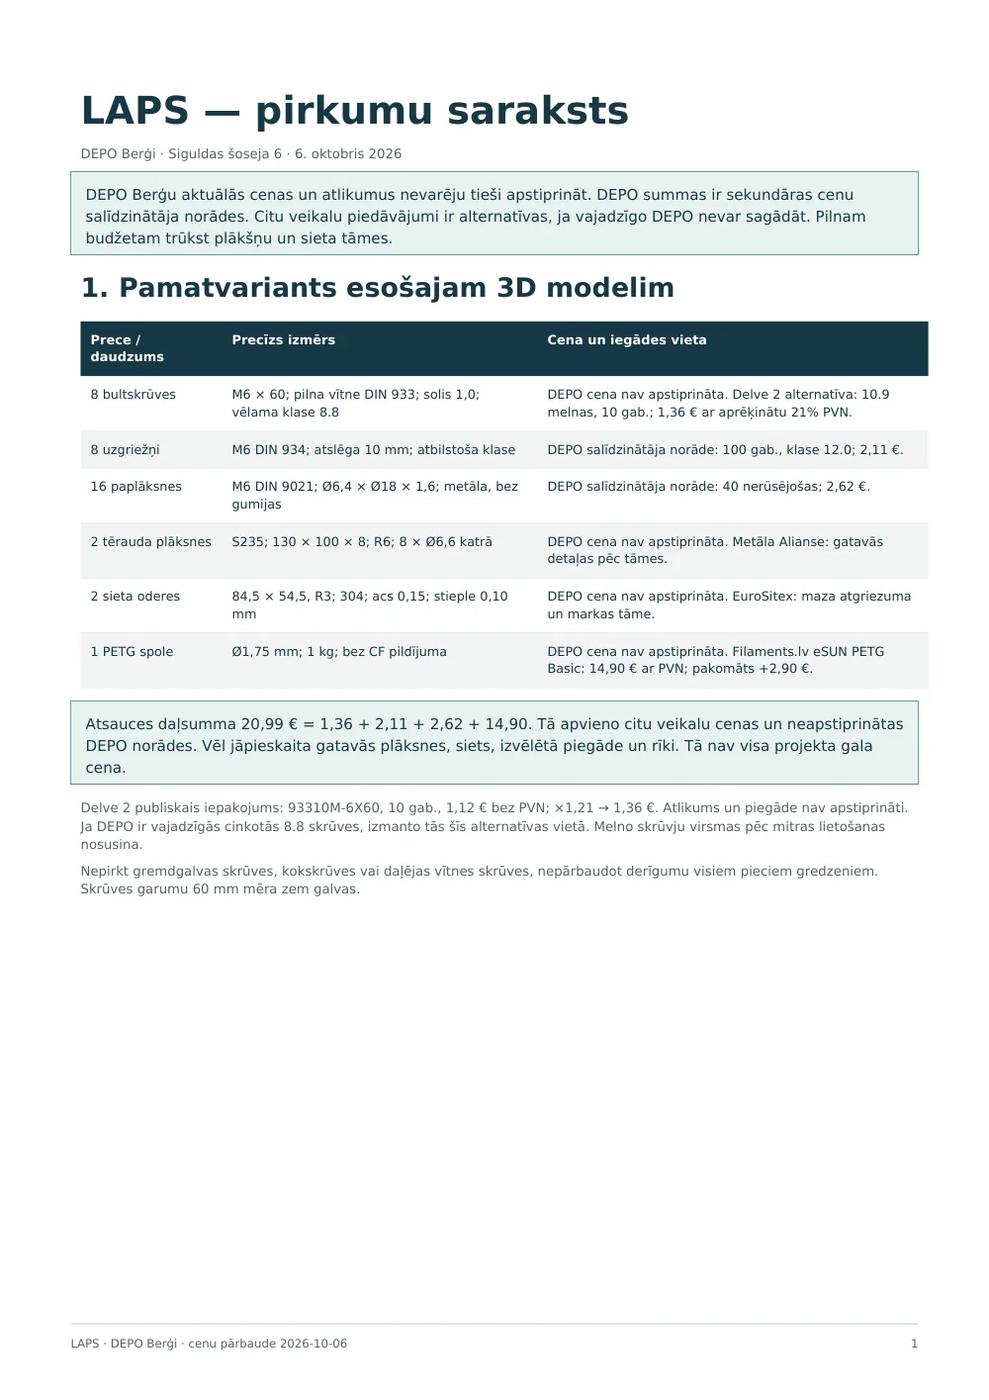
dist/documents/pages/iepirkums-01.webp
