brantemadara-spec/laps/dist/documents/pages/iepirkums-02.webp

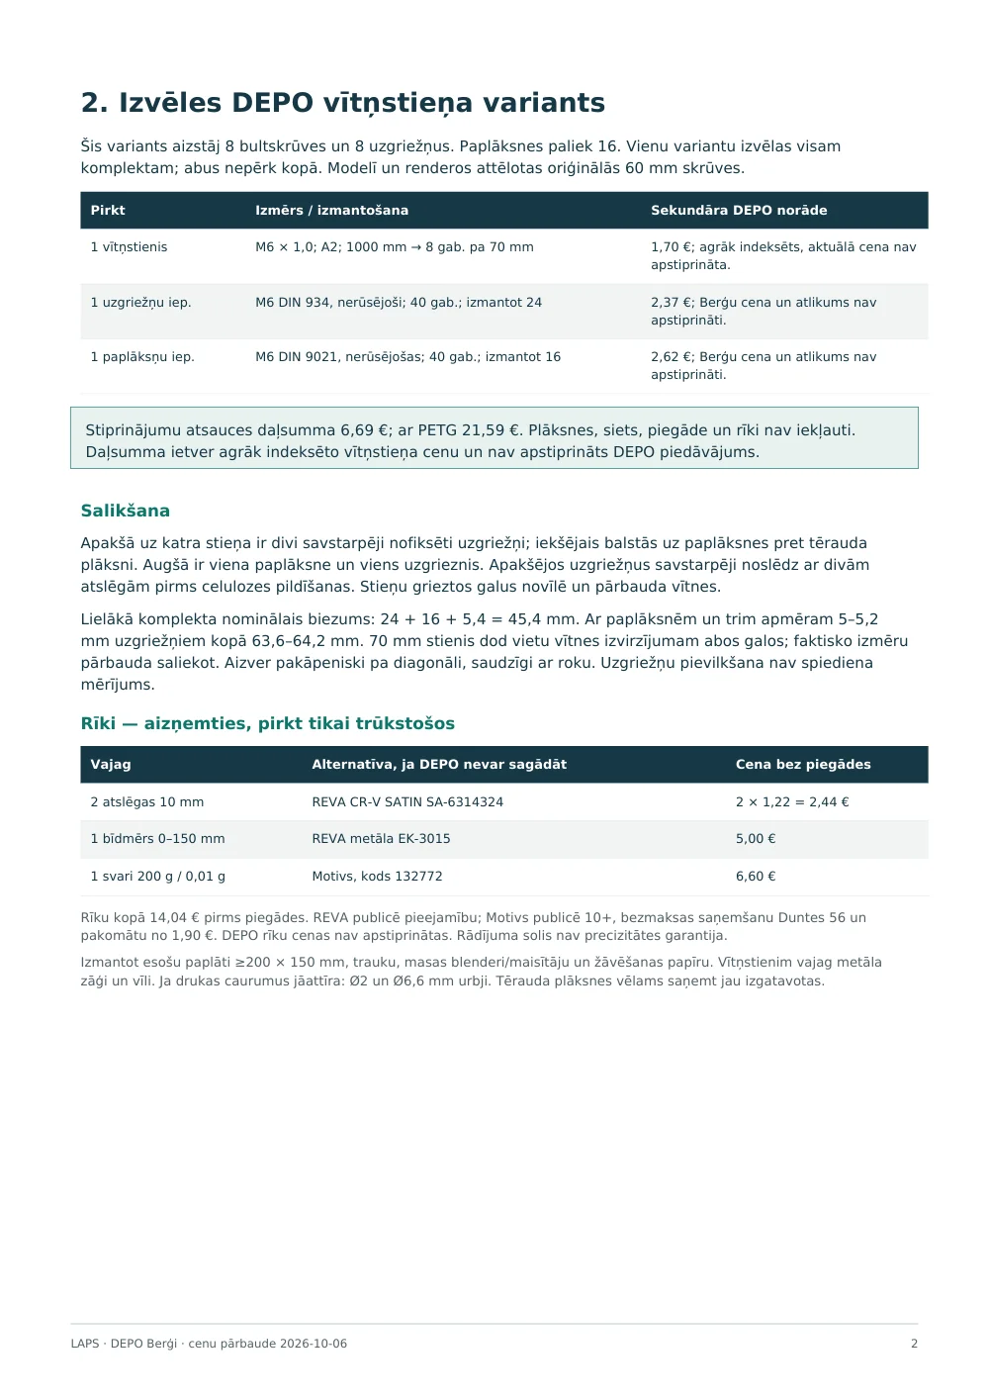
dist/documents/pages/iepirkums-02.webp
