brantemadara-spec/laps/dist/documents/pages/iepirkums-03.webp

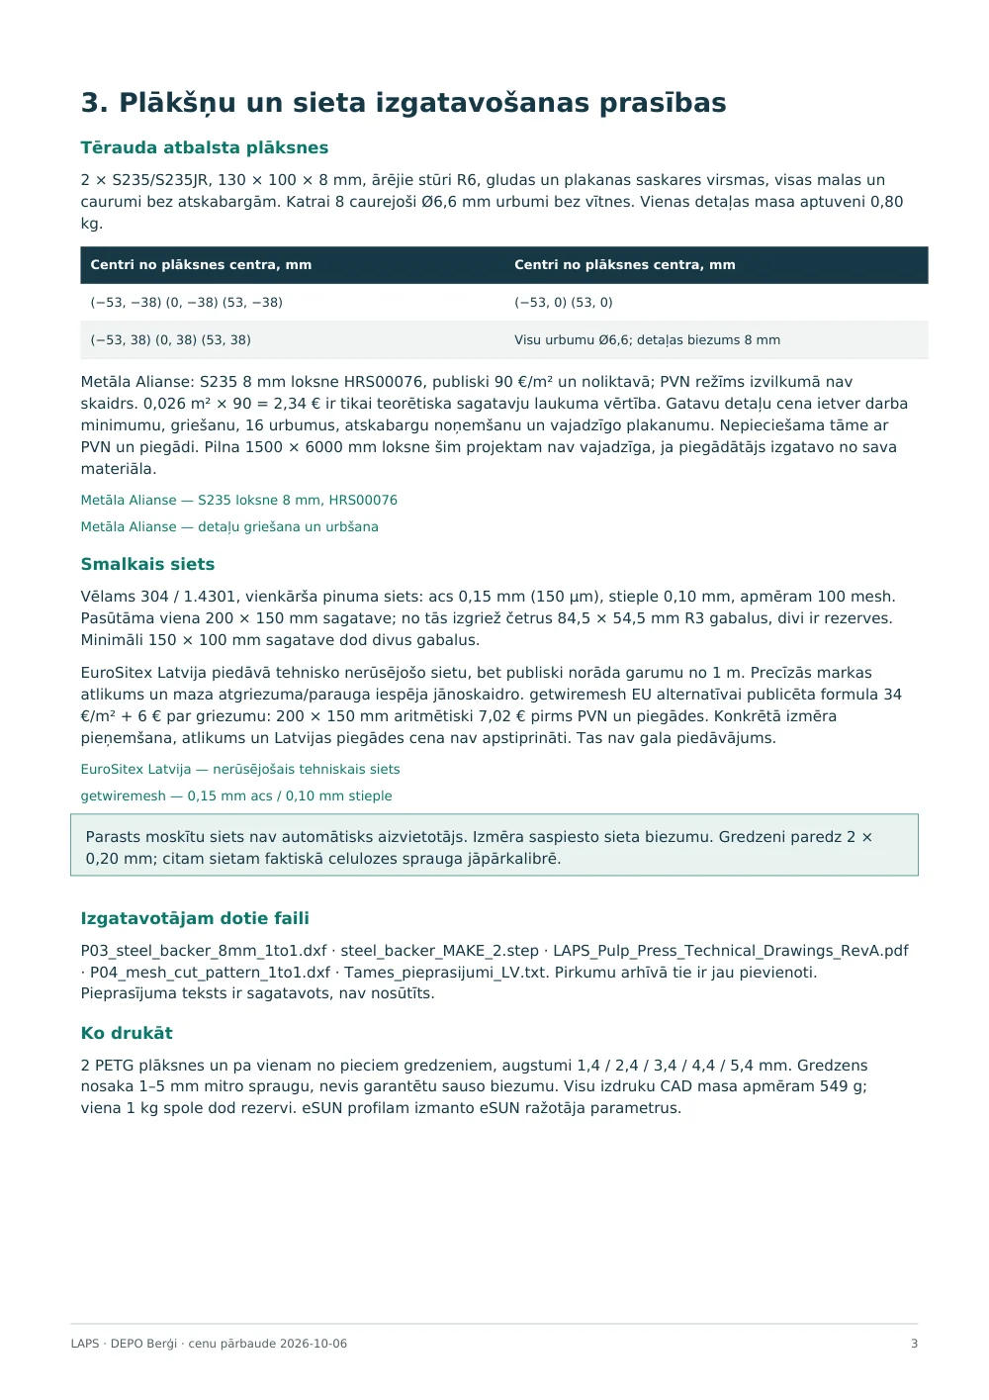
dist/documents/pages/iepirkums-03.webp
