brantemadara-spec/laps/dist/documents/pages/iepirkums-04.webp

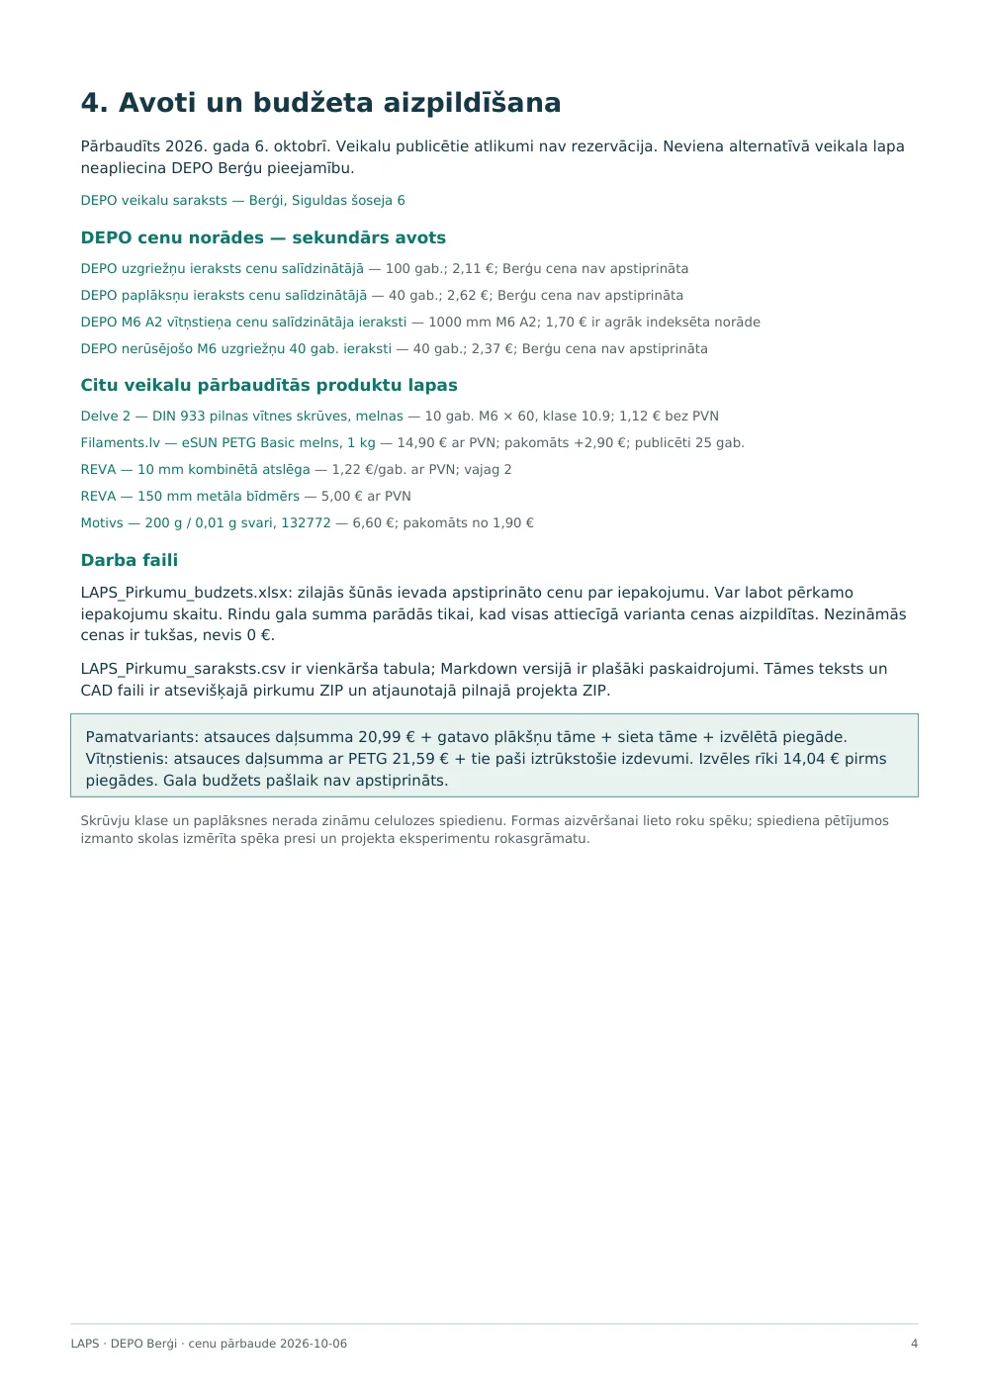
dist/documents/pages/iepirkums-04.webp
