brantemadara-spec/laps/dist/documents/pages/petijumi-01.webp

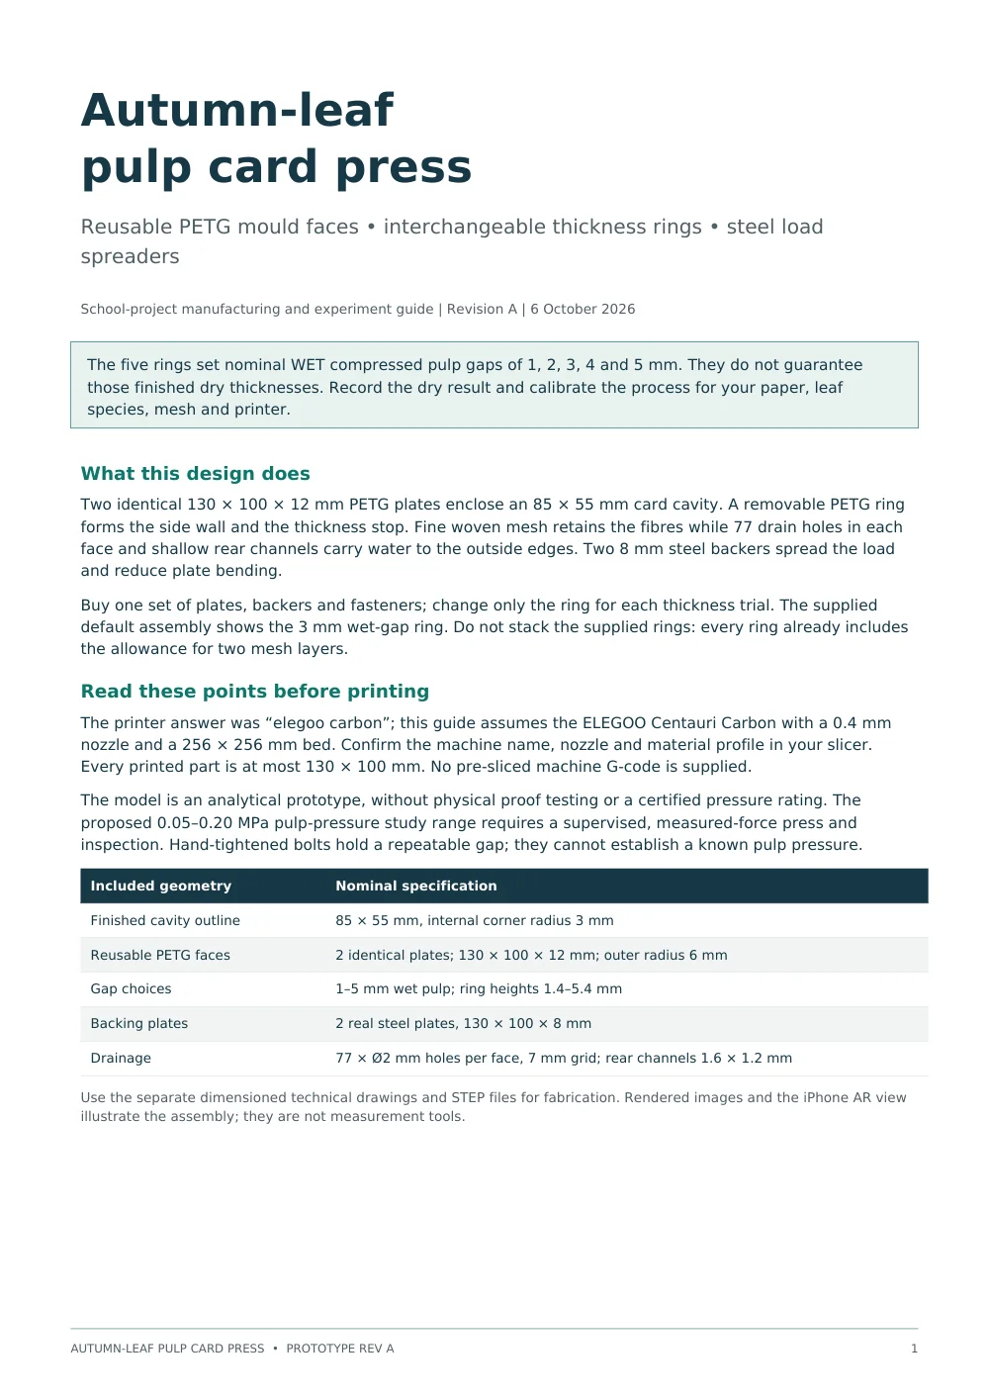
dist/documents/pages/petijumi-01.webp
