brantemadara-spec/laps/dist/documents/pages/petijumi-02.webp

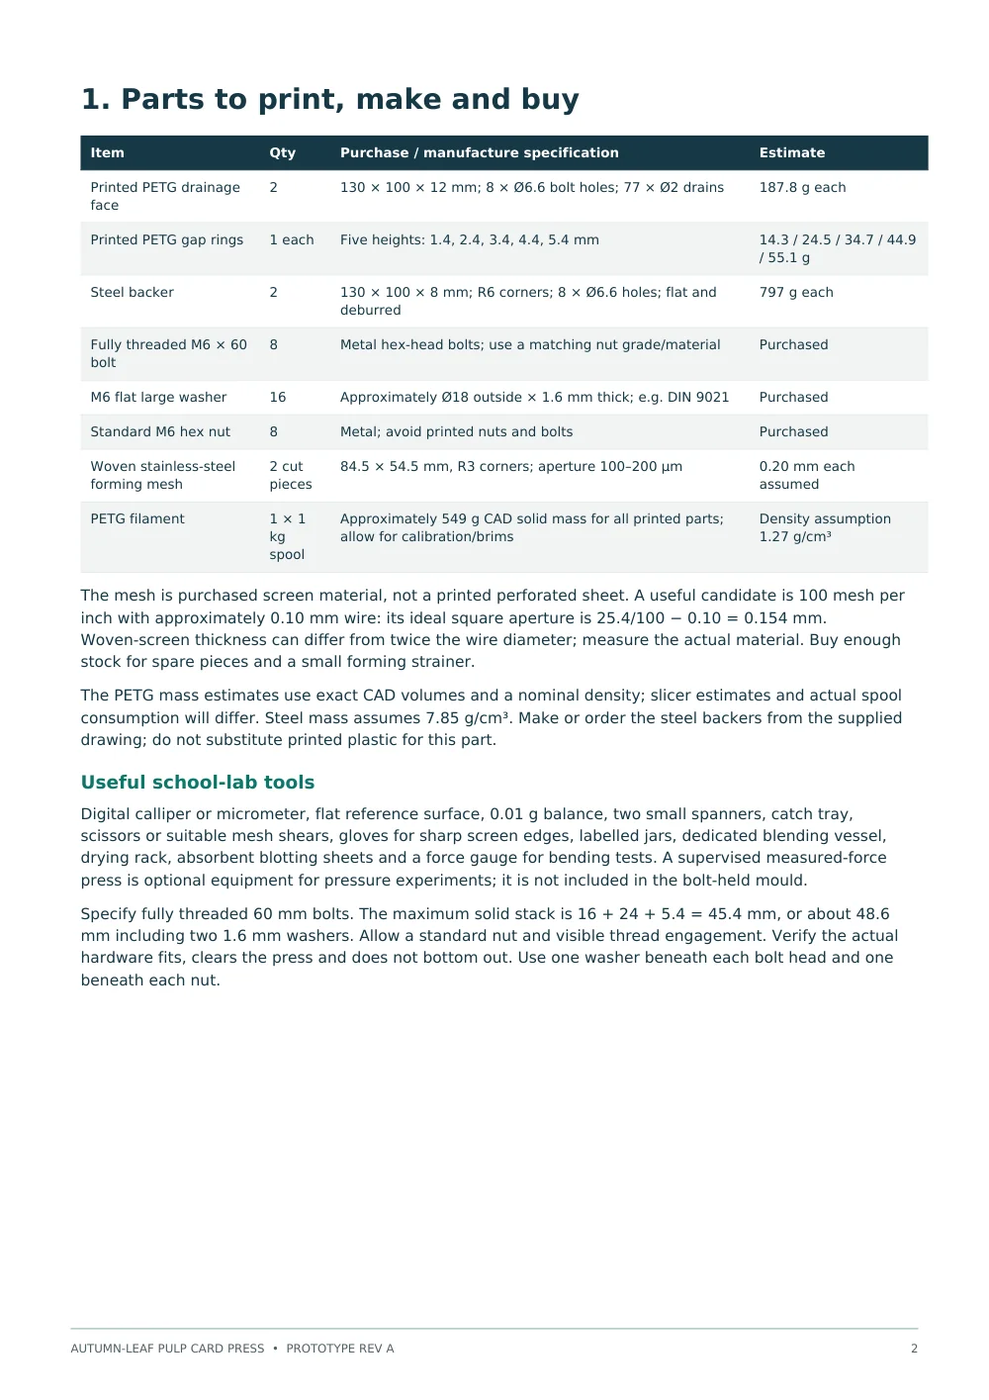
dist/documents/pages/petijumi-02.webp
