brantemadara-spec/laps/dist/documents/pages/petijumi-03.webp

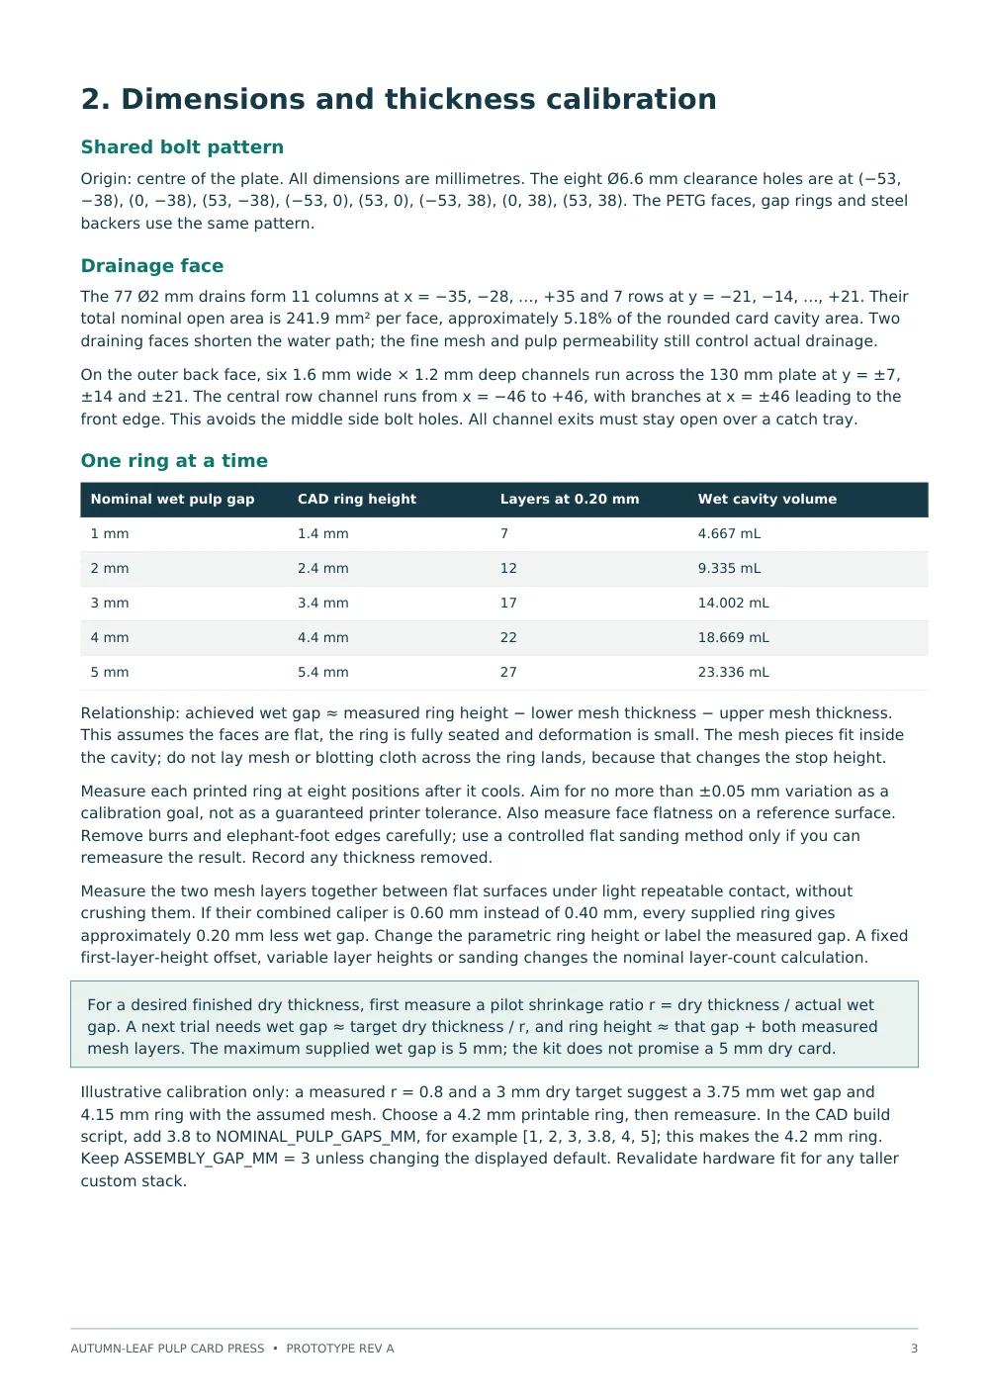
dist/documents/pages/petijumi-03.webp
