brantemadara-spec/laps/dist/documents/pages/petijumi-04.webp

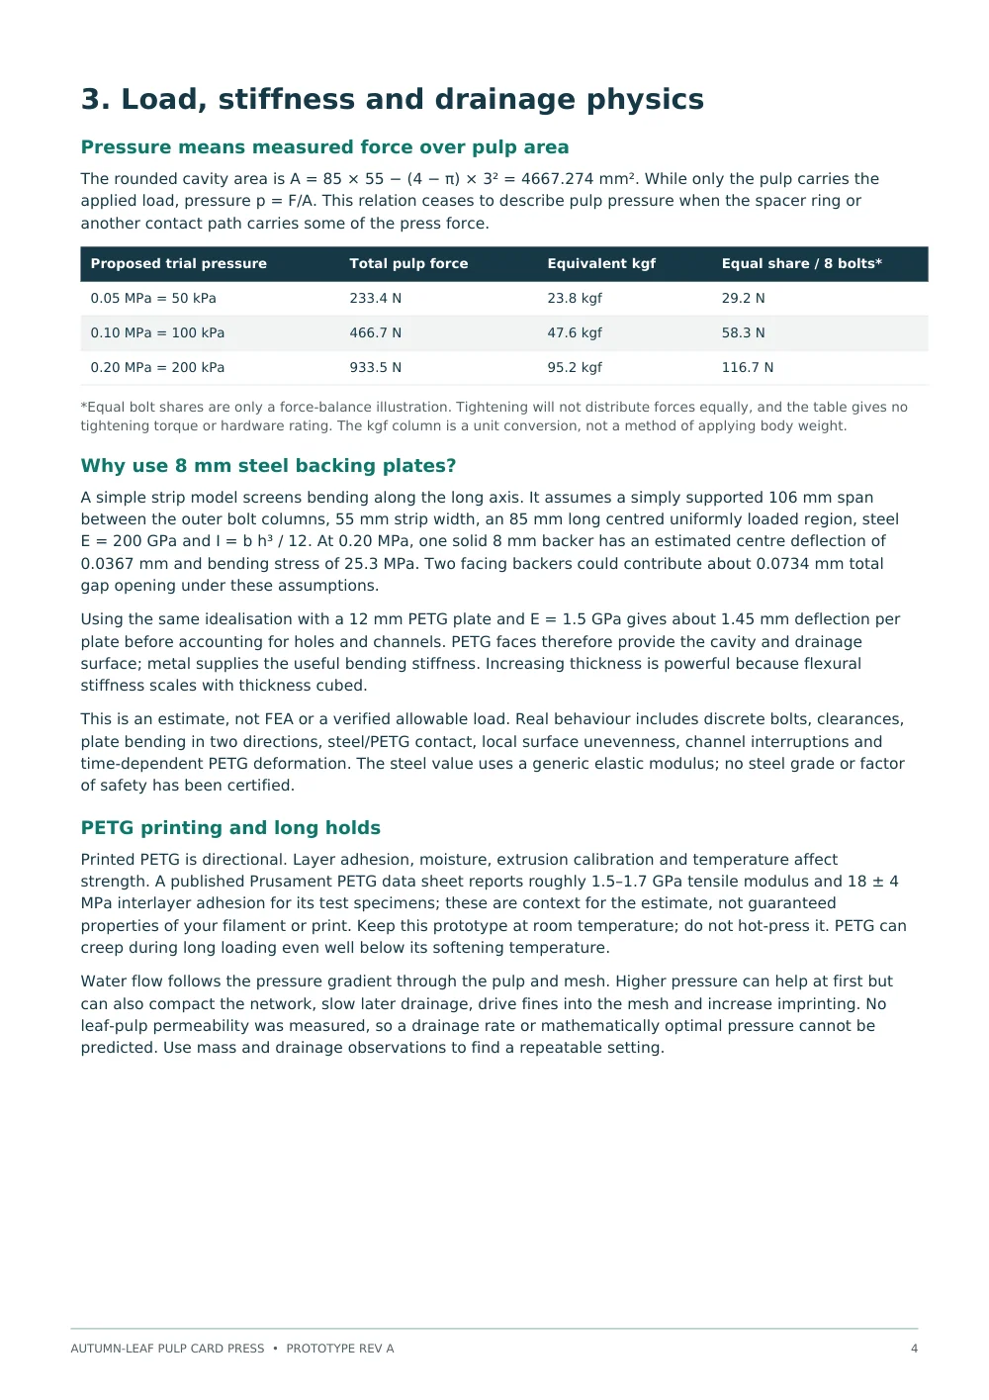
dist/documents/pages/petijumi-04.webp
