brantemadara-spec/laps/dist/documents/pages/petijumi-05.webp

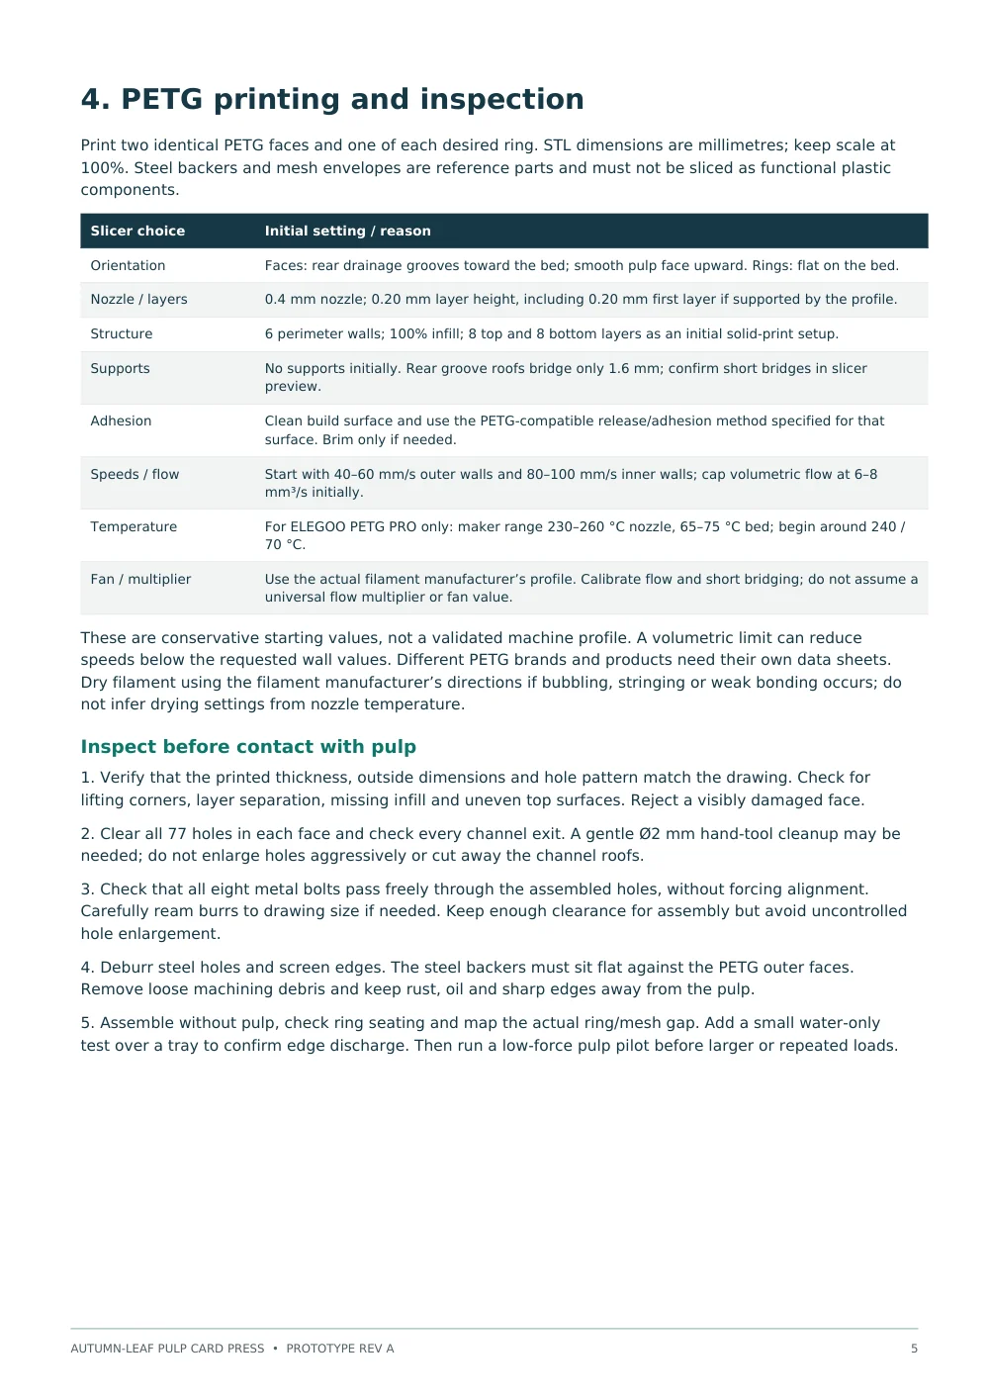
dist/documents/pages/petijumi-05.webp
