brantemadara-spec/laps/dist/documents/pages/petijumi-06.webp

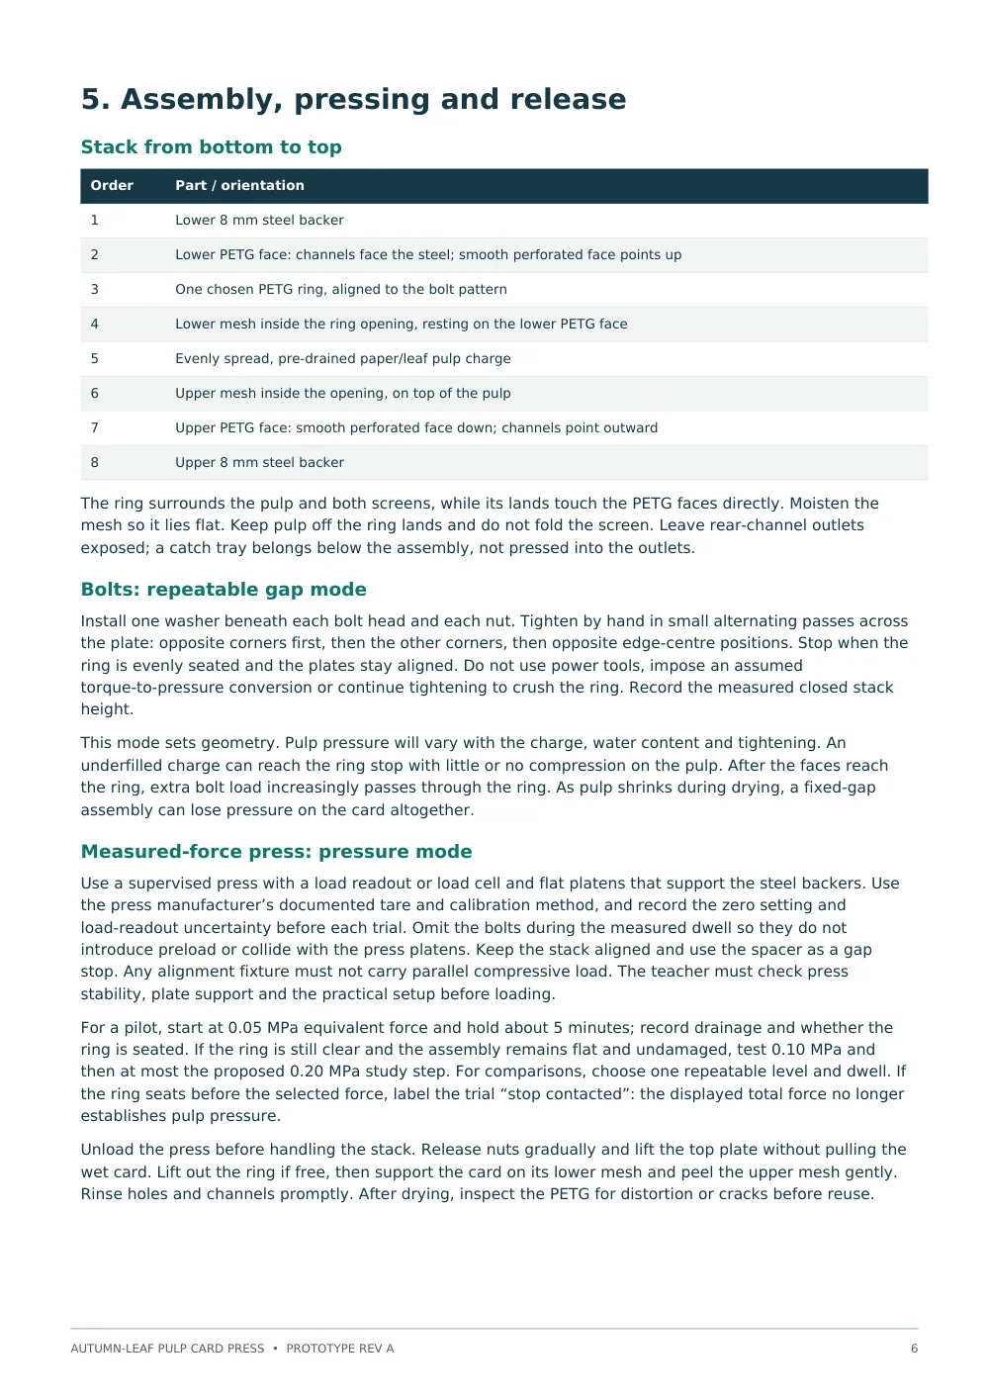
dist/documents/pages/petijumi-06.webp
