brantemadara-spec/laps/dist/documents/pages/petijumi-07.webp

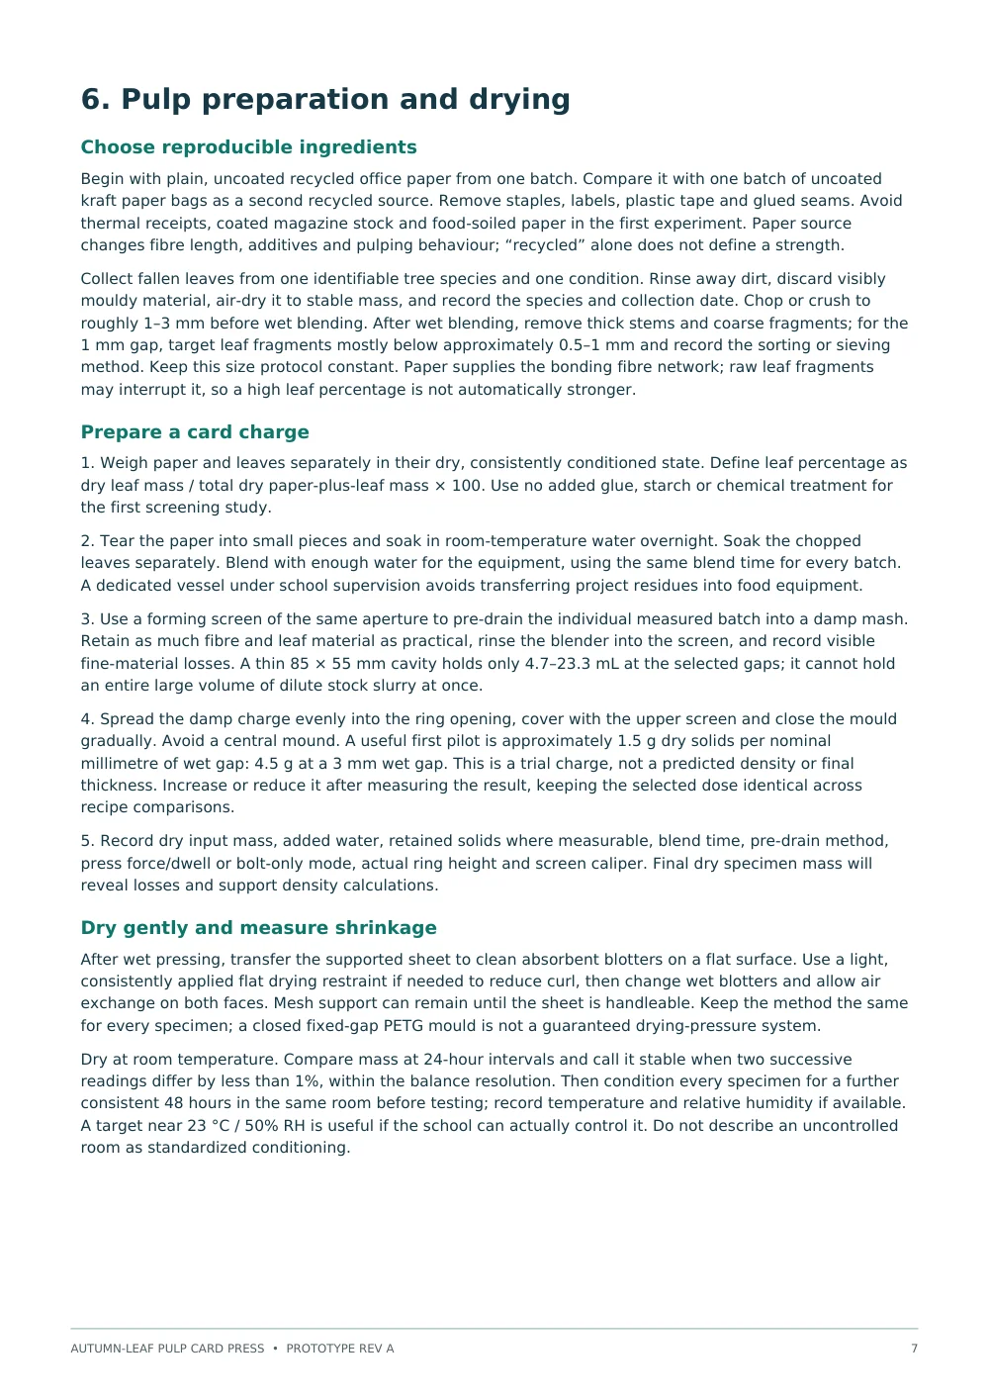
dist/documents/pages/petijumi-07.webp
