brantemadara-spec/laps/dist/documents/pages/petijumi-08.webp

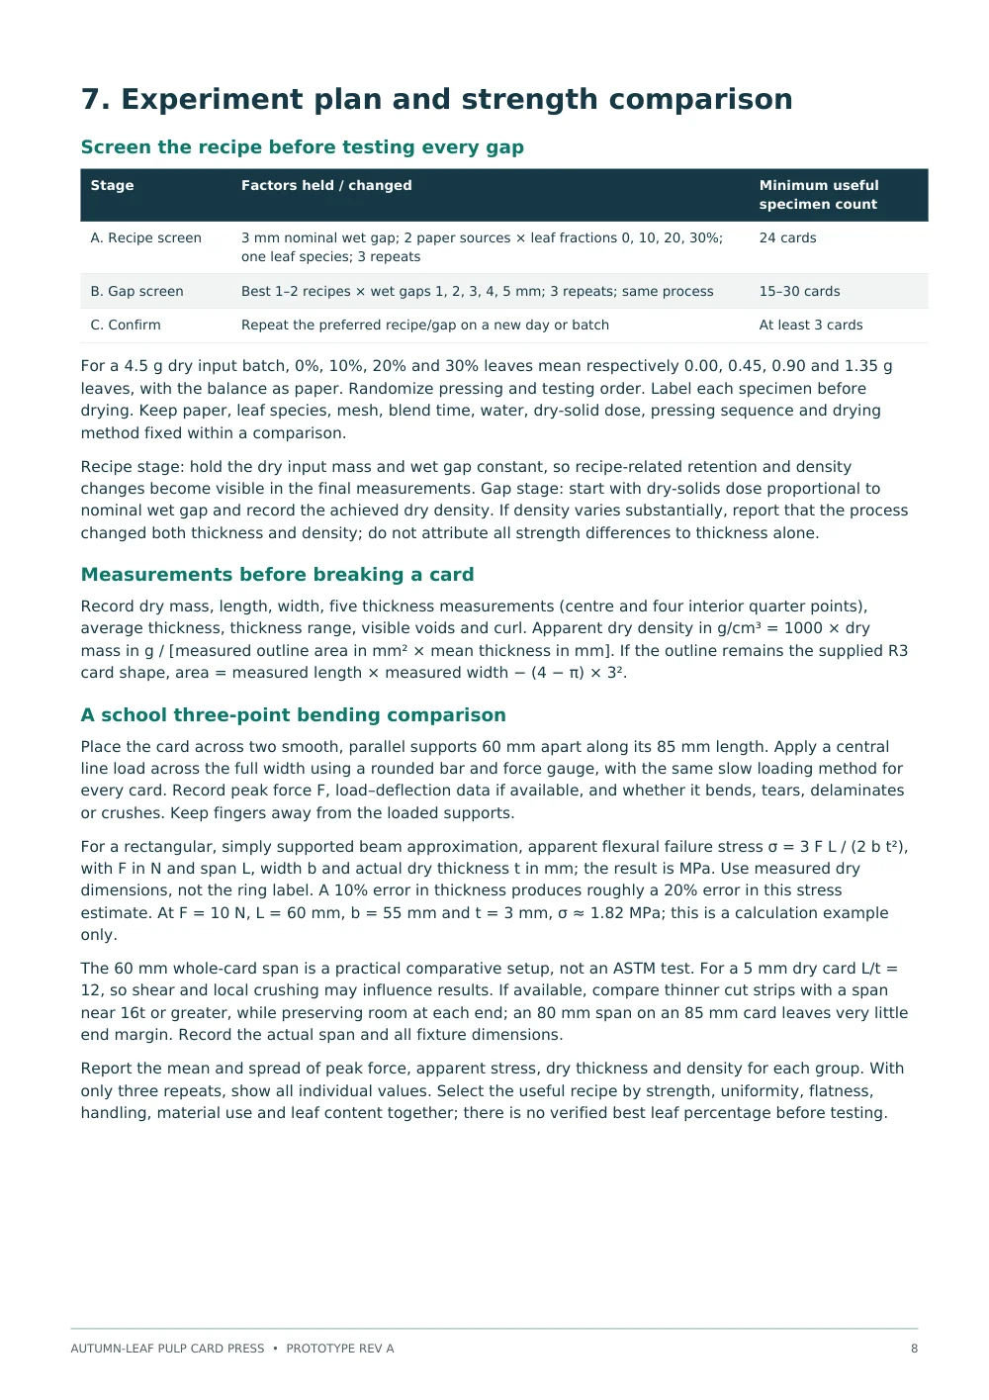
dist/documents/pages/petijumi-08.webp
