brantemadara-spec/laps/dist/documents/pages/petijumi-09.webp

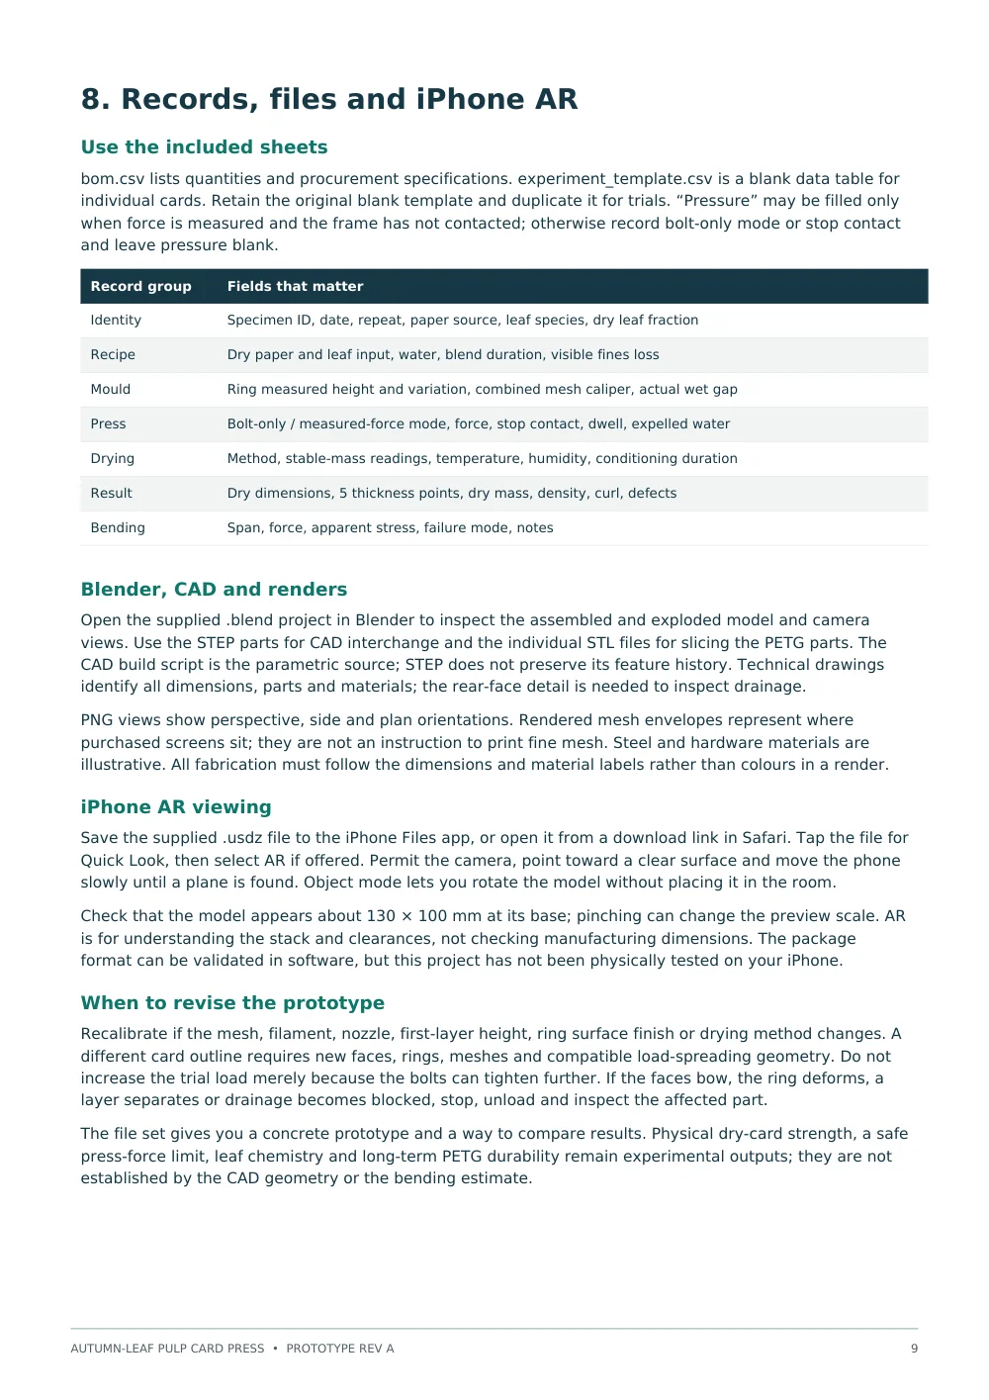
dist/documents/pages/petijumi-09.webp
