brantemadara-spec/laps/dist/documents/pages/petijumi-10.webp

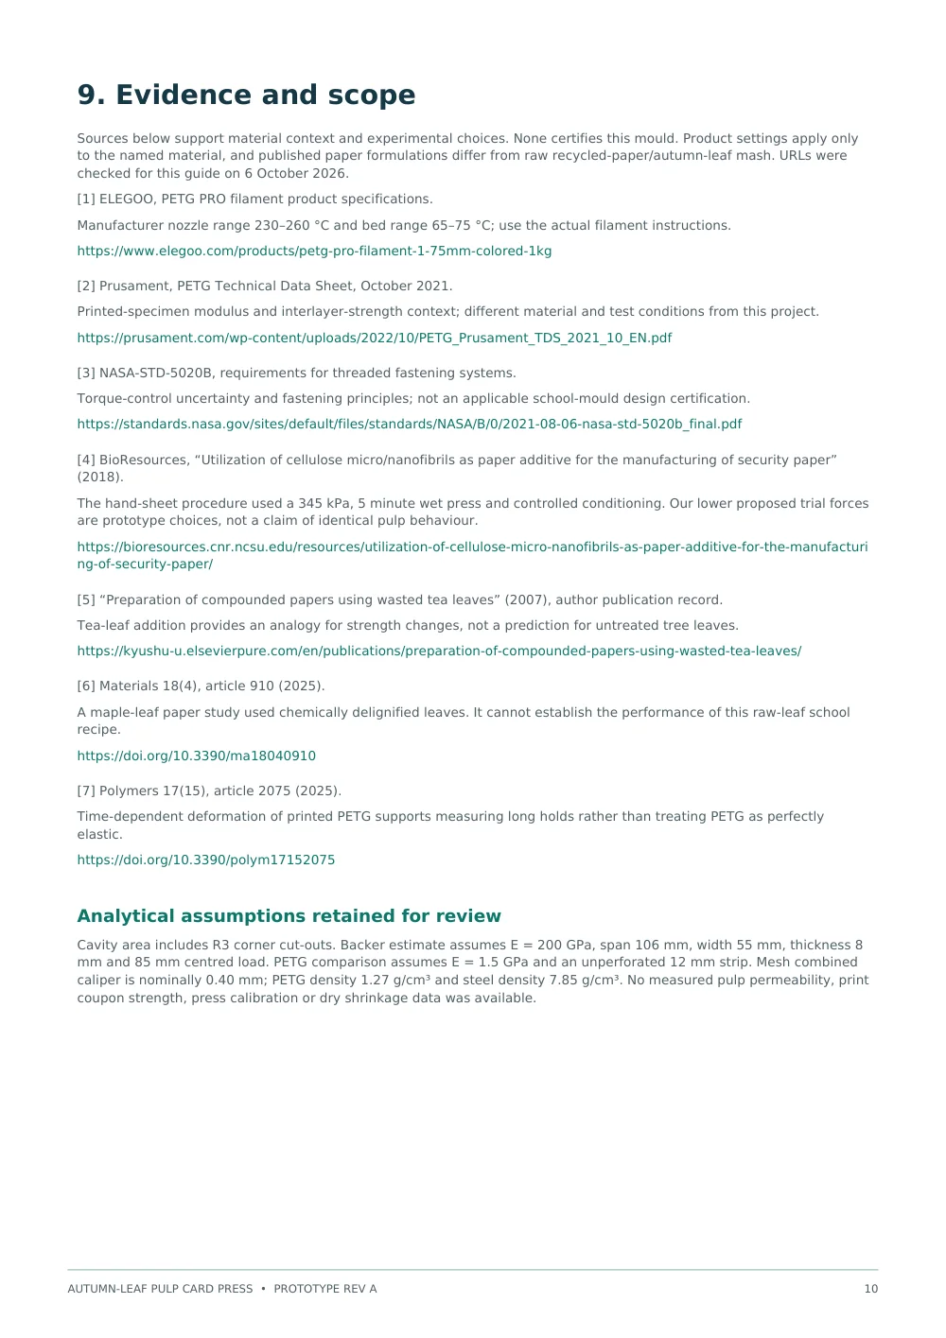
dist/documents/pages/petijumi-10.webp
