brantemadara-spec/laps/dist/documents/pages/rasejumi-01.webp

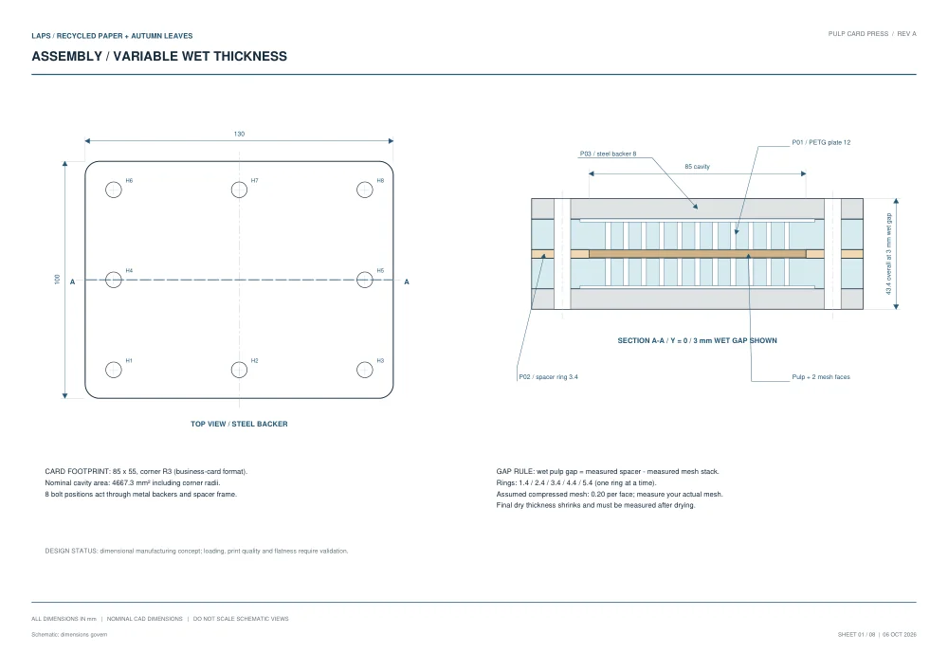
dist/documents/pages/rasejumi-01.webp
