brantemadara-spec/laps/dist/documents/pages/rasejumi-02.webp

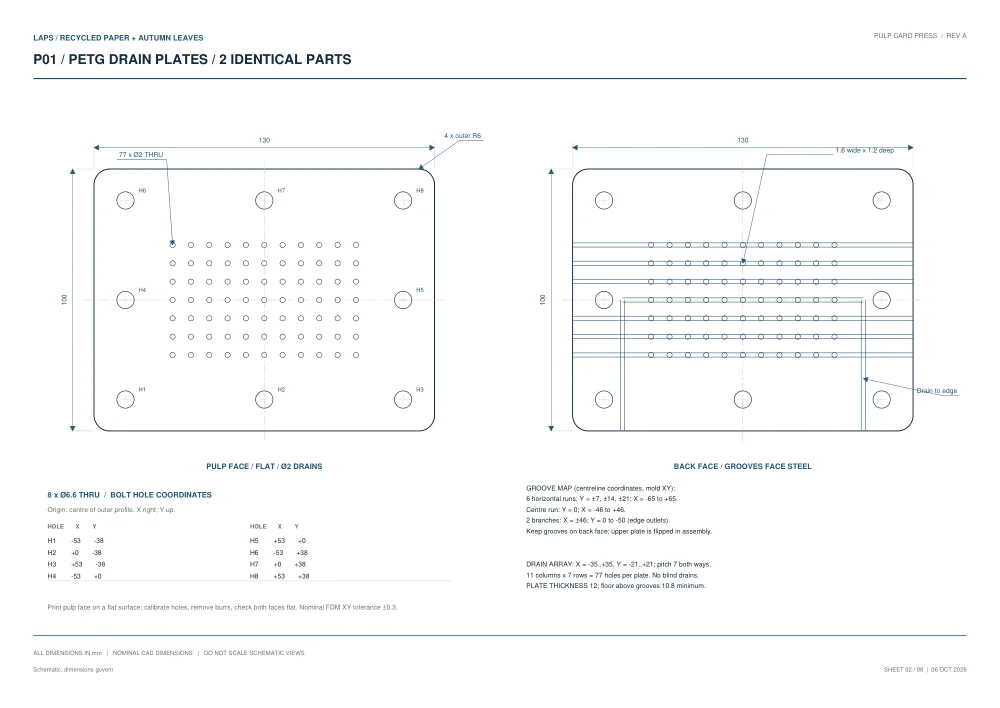
dist/documents/pages/rasejumi-02.webp
