brantemadara-spec/laps/dist/documents/pages/rasejumi-03.webp

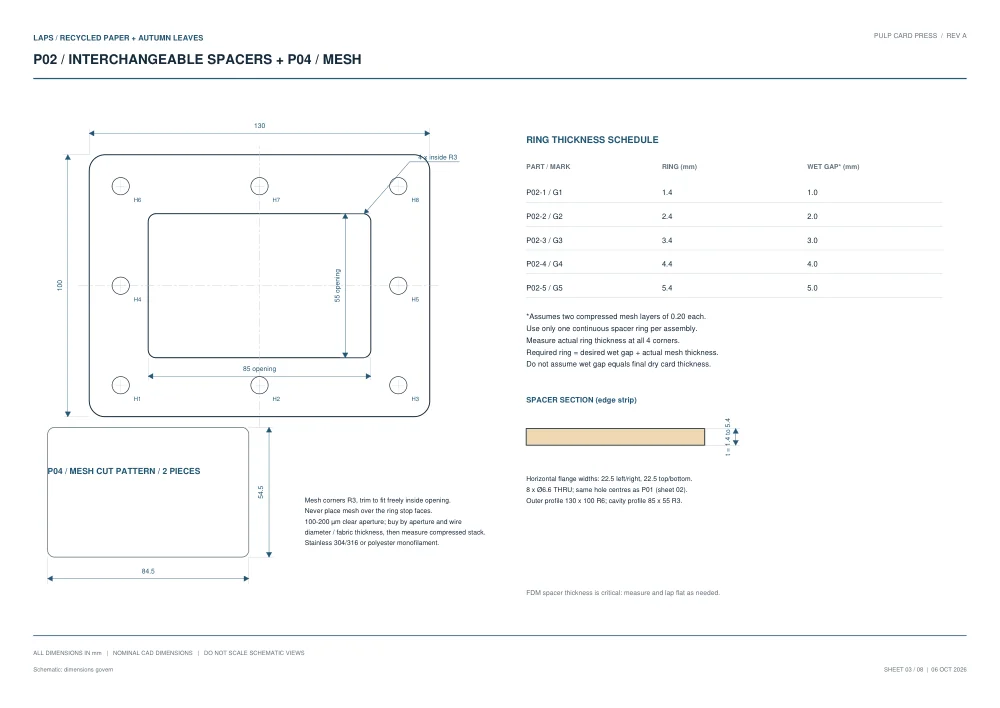
dist/documents/pages/rasejumi-03.webp
