brantemadara-spec/laps/dist/documents/pages/rasejumi-04.webp

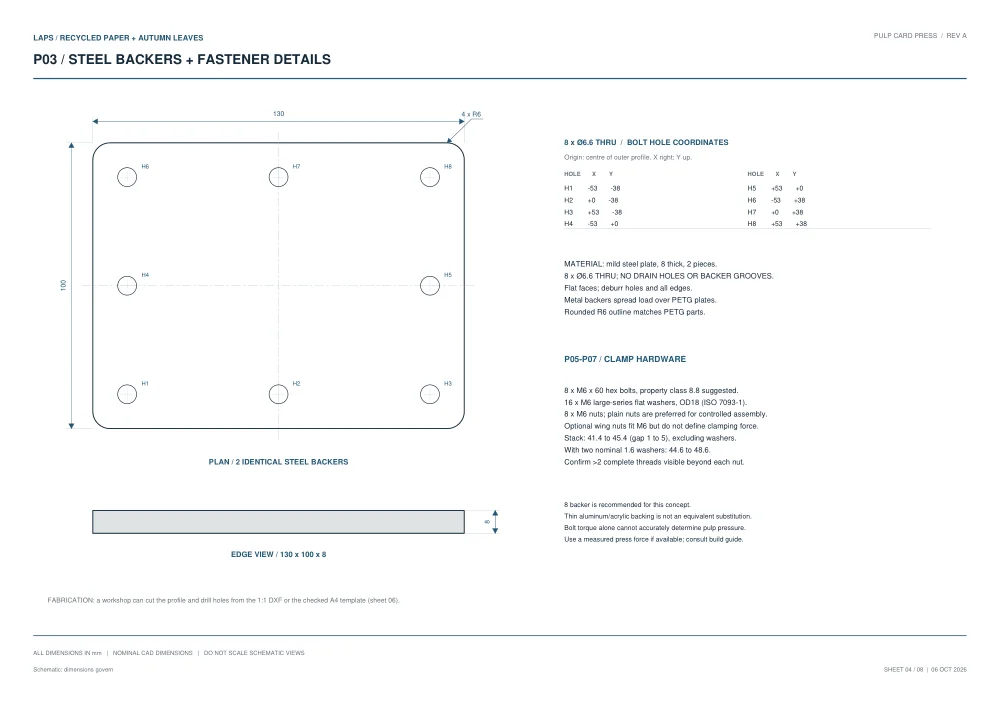
dist/documents/pages/rasejumi-04.webp
