brantemadara-spec/laps/dist/documents/pages/rasejumi-05.webp

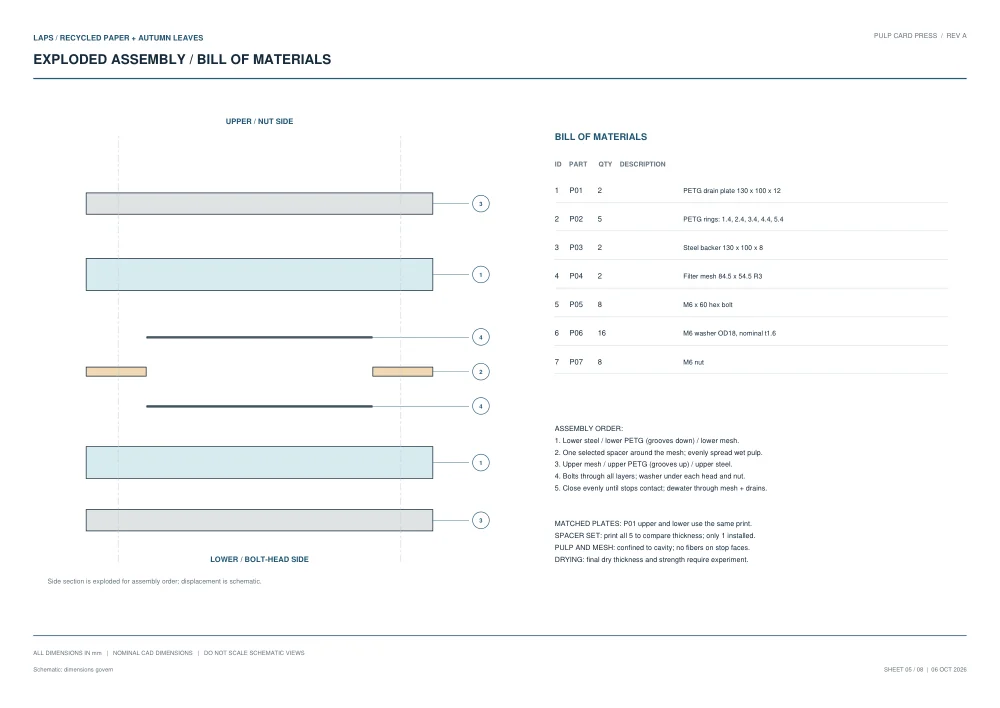
dist/documents/pages/rasejumi-05.webp
