brantemadara-spec/laps/dist/documents/pages/rasejumi-06.webp

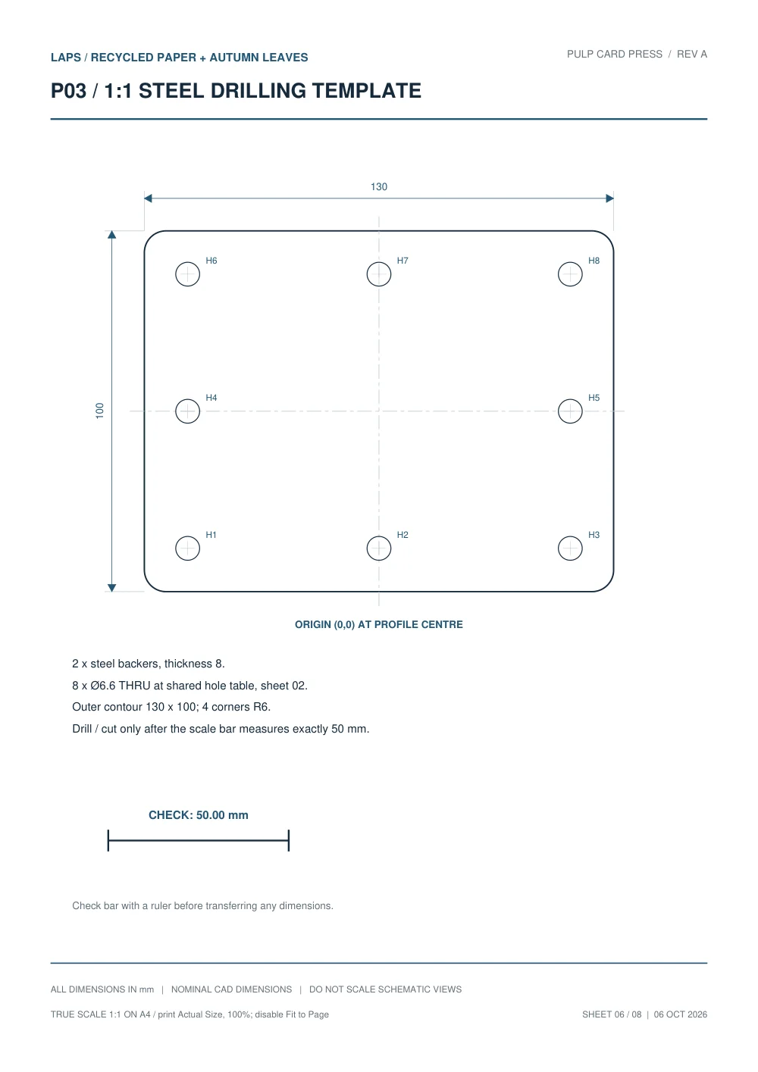
dist/documents/pages/rasejumi-06.webp
