brantemadara-spec/laps/dist/documents/pages/rasejumi-07.webp

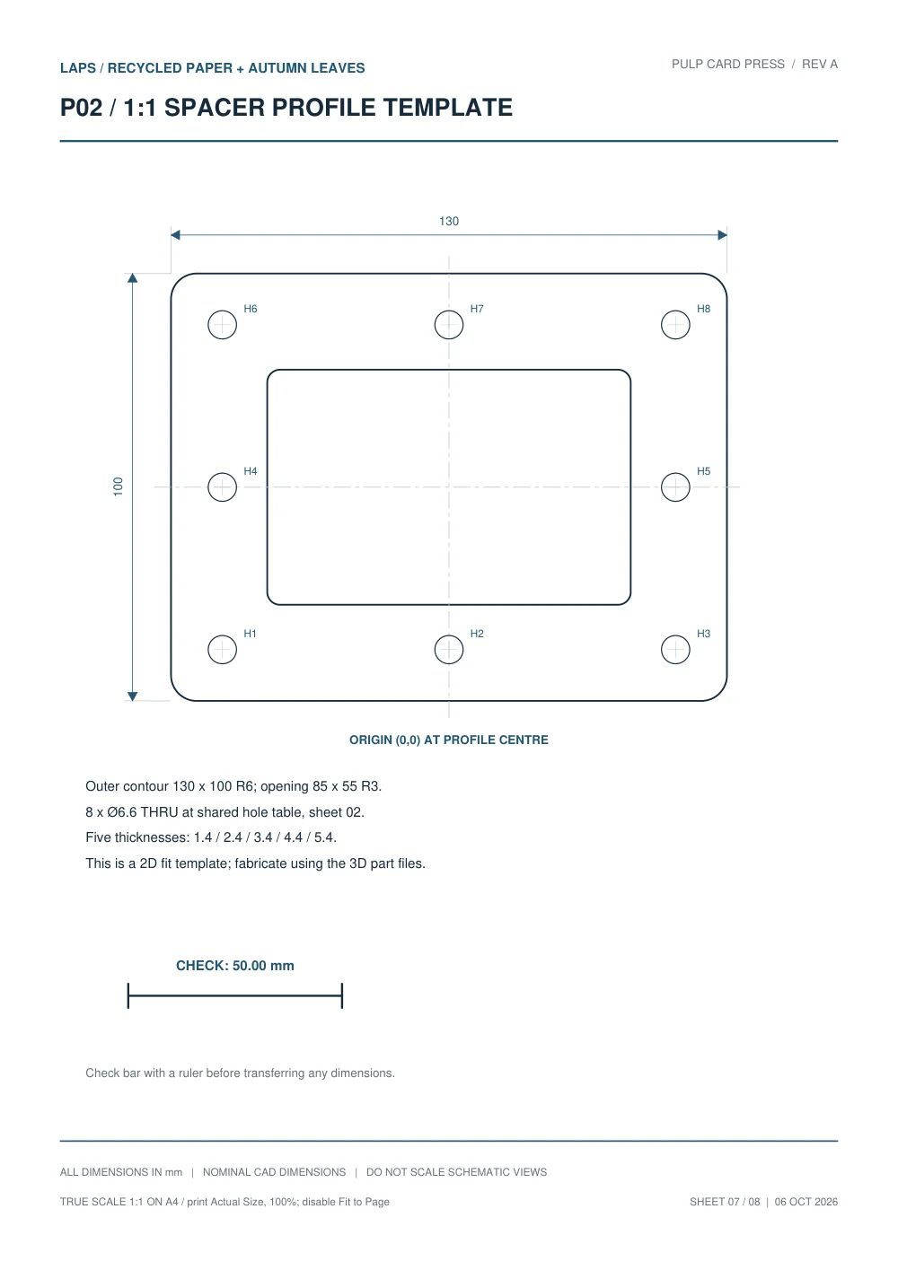
dist/documents/pages/rasejumi-07.webp
