brantemadara-spec/laps/dist/documents/pages/rasejumi-08.webp

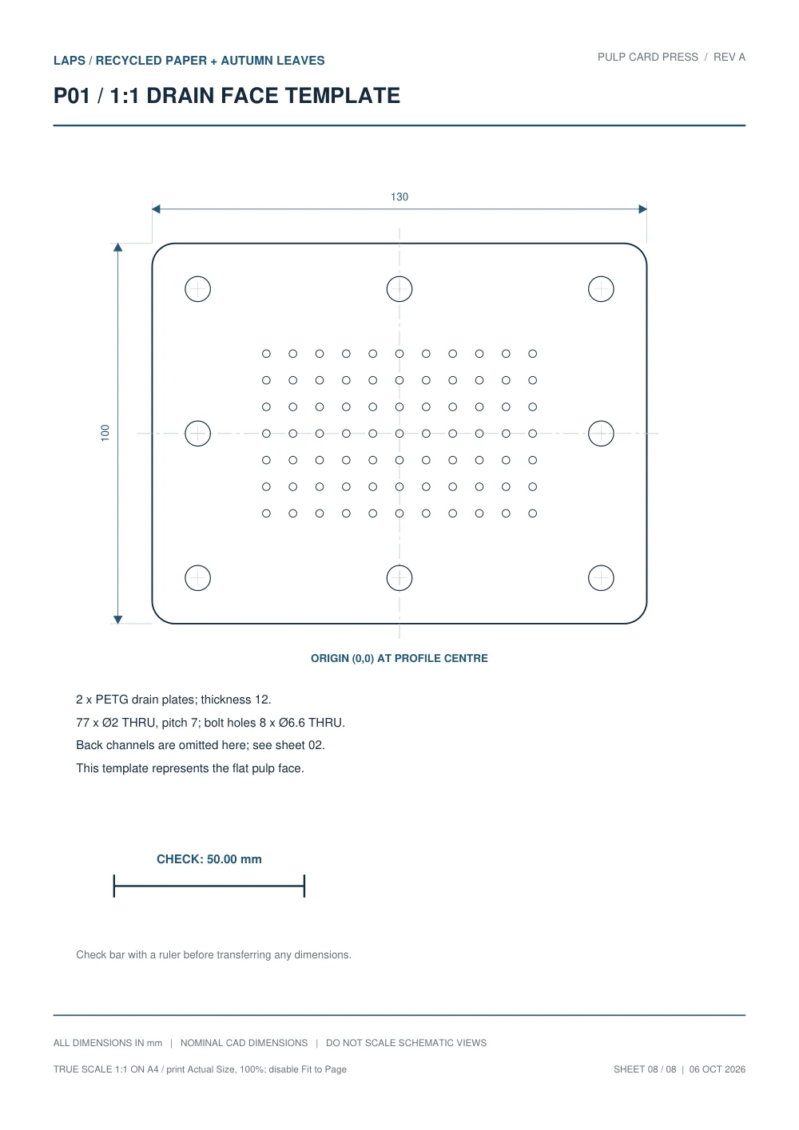
dist/documents/pages/rasejumi-08.webp
