brantemadara-spec/laps/dist/documents/pages/skice-01.webp

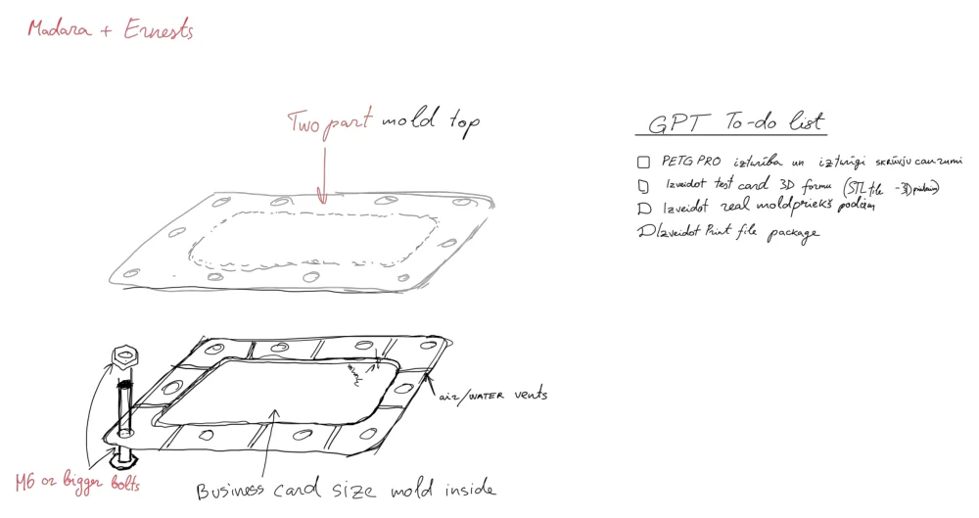
dist/documents/pages/skice-01.webp
