brantemadara-spec/laps/dist/images/presforma.png

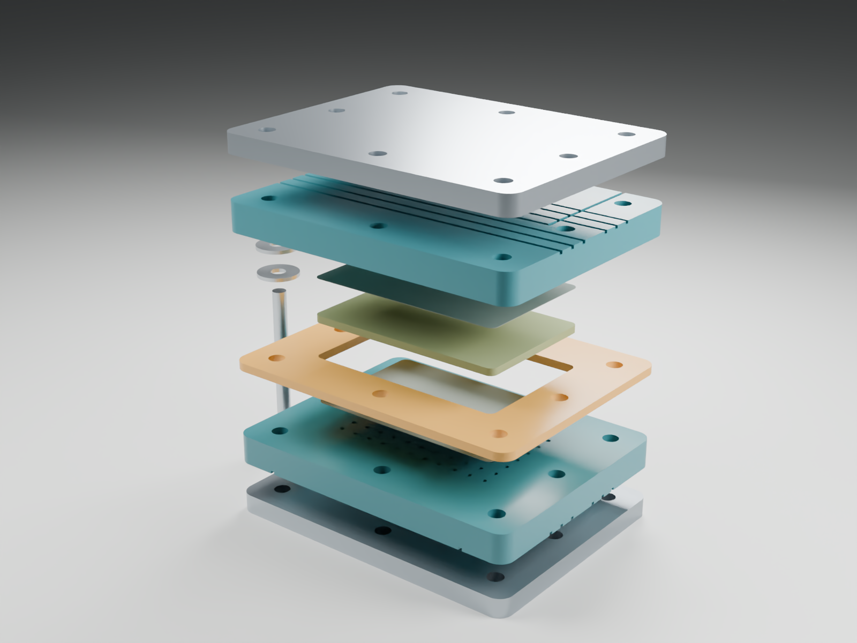
dist/images/presforma.png
