brantemadara-spec/laps/dist/images/render-03.webp

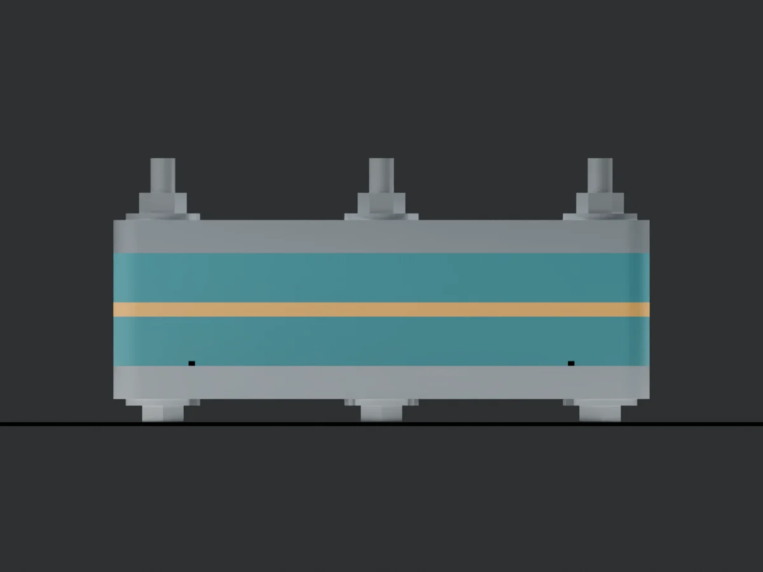
dist/images/render-03.webp
