brantemadara-spec/laps/dist/images/render-04.webp

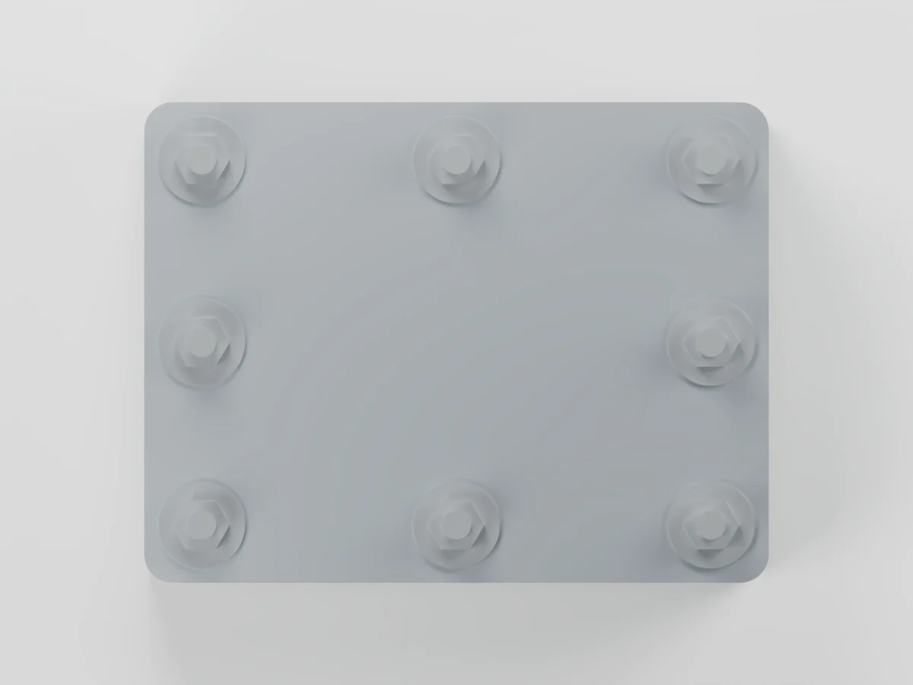
dist/images/render-04.webp
