brantemadara-spec/laps/dist/images/render-05.webp

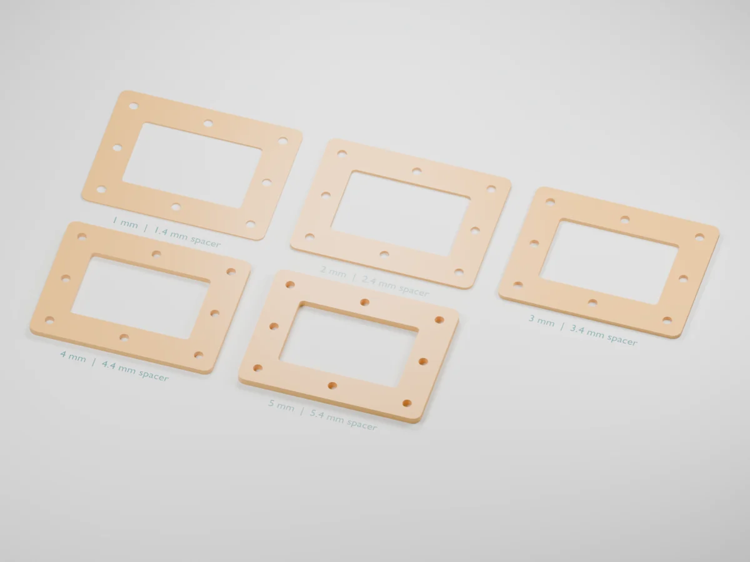
dist/images/render-05.webp
