brantemadara-spec/laps/dist/images/render-06.webp

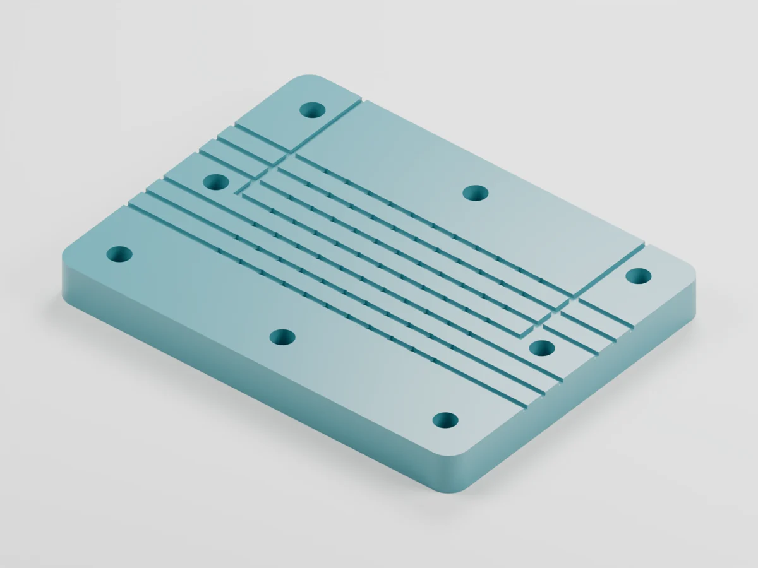
dist/images/render-06.webp
