brantemadara-spec/laps/dist/images/render-07.webp

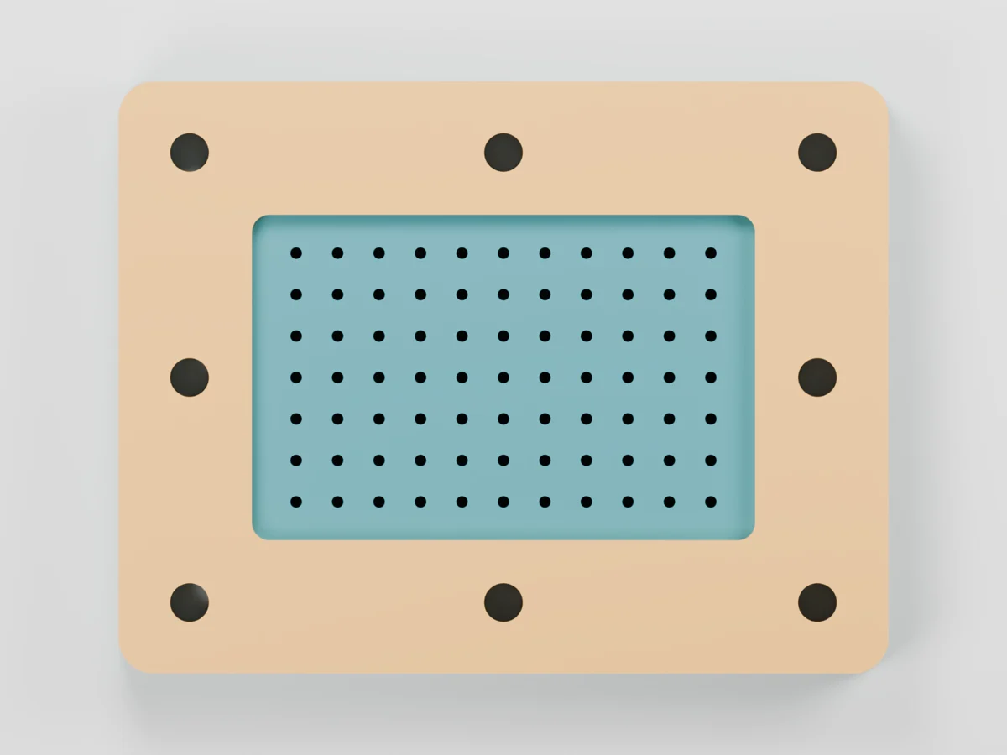
dist/images/render-07.webp
