brantemadara-spec/laps/dist/laps-siets/documents/procurement-01.webp

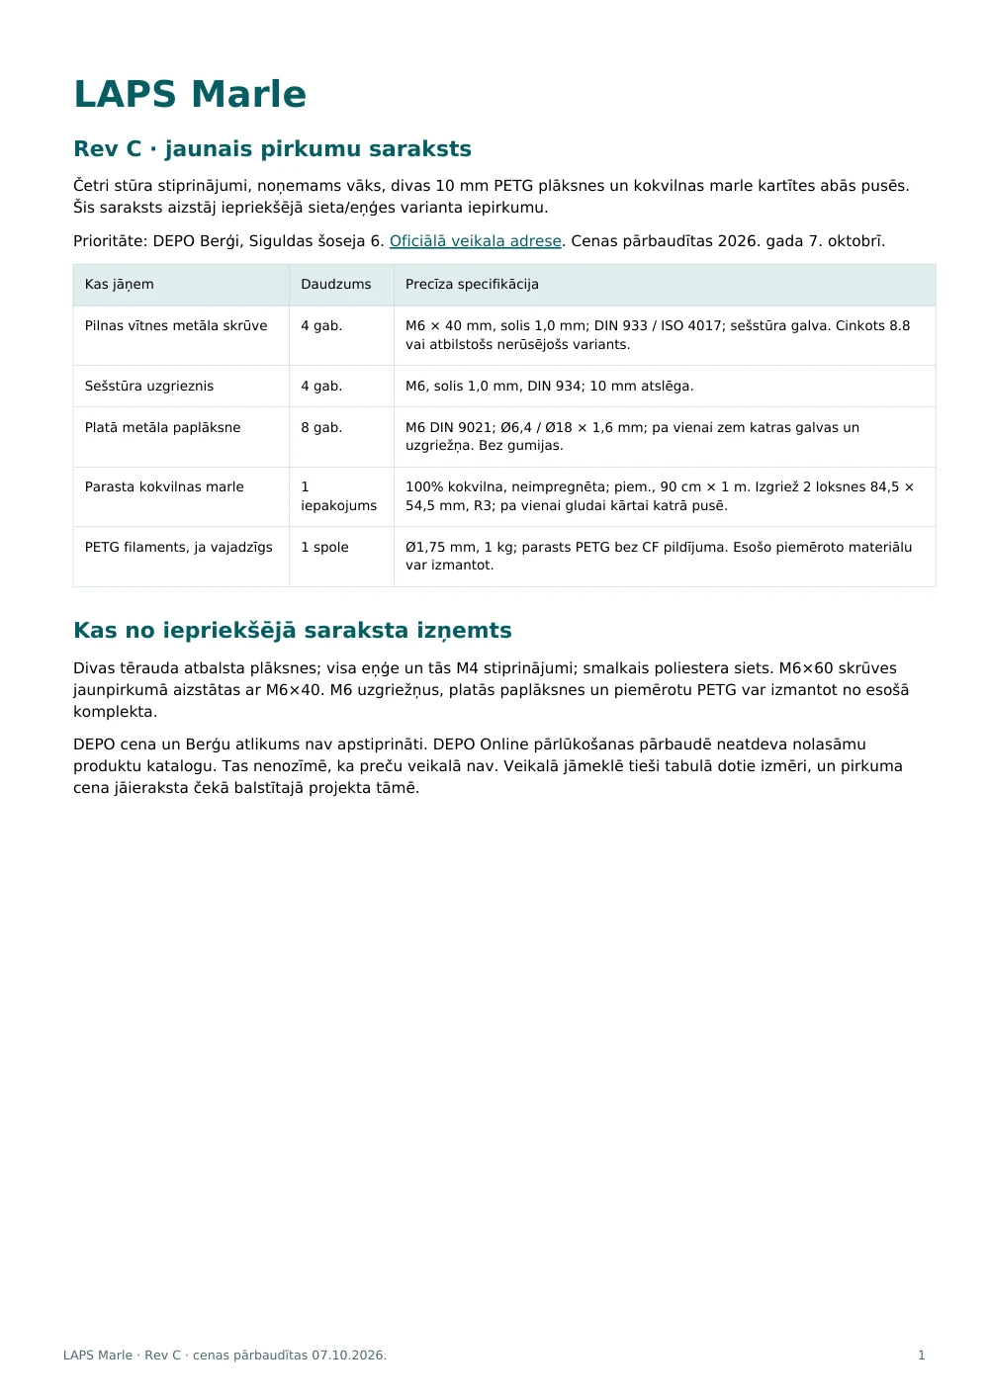
dist/laps-siets/documents/procurement-01.webp
