brantemadara-spec/laps/dist/laps-siets/documents/procurement-02.webp

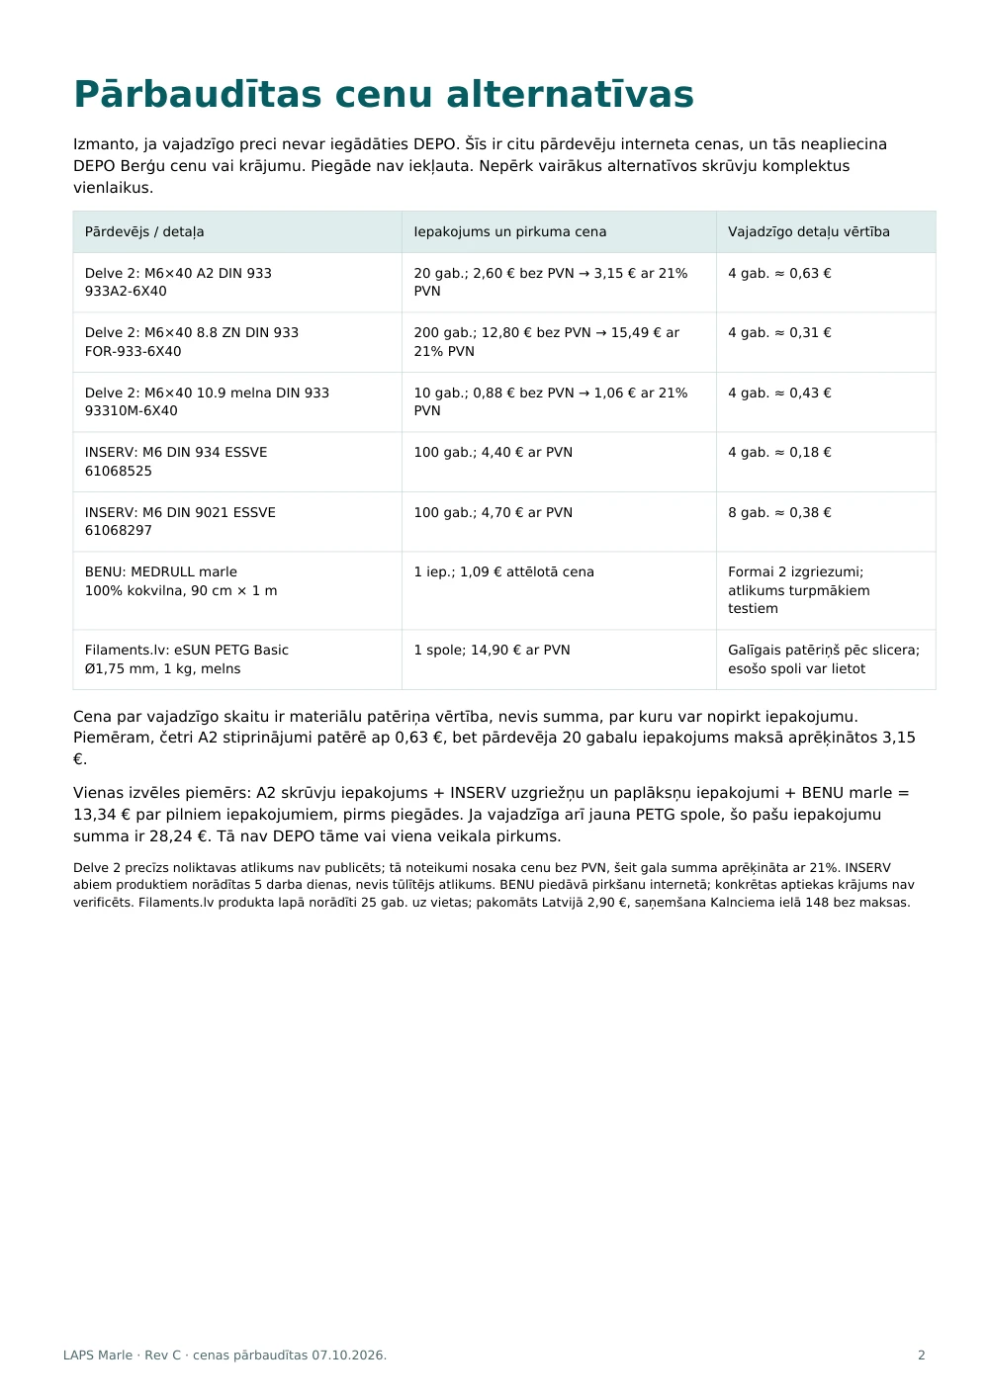
dist/laps-siets/documents/procurement-02.webp
