brantemadara-spec/laps/dist/laps-siets/documents/procurement-03.webp

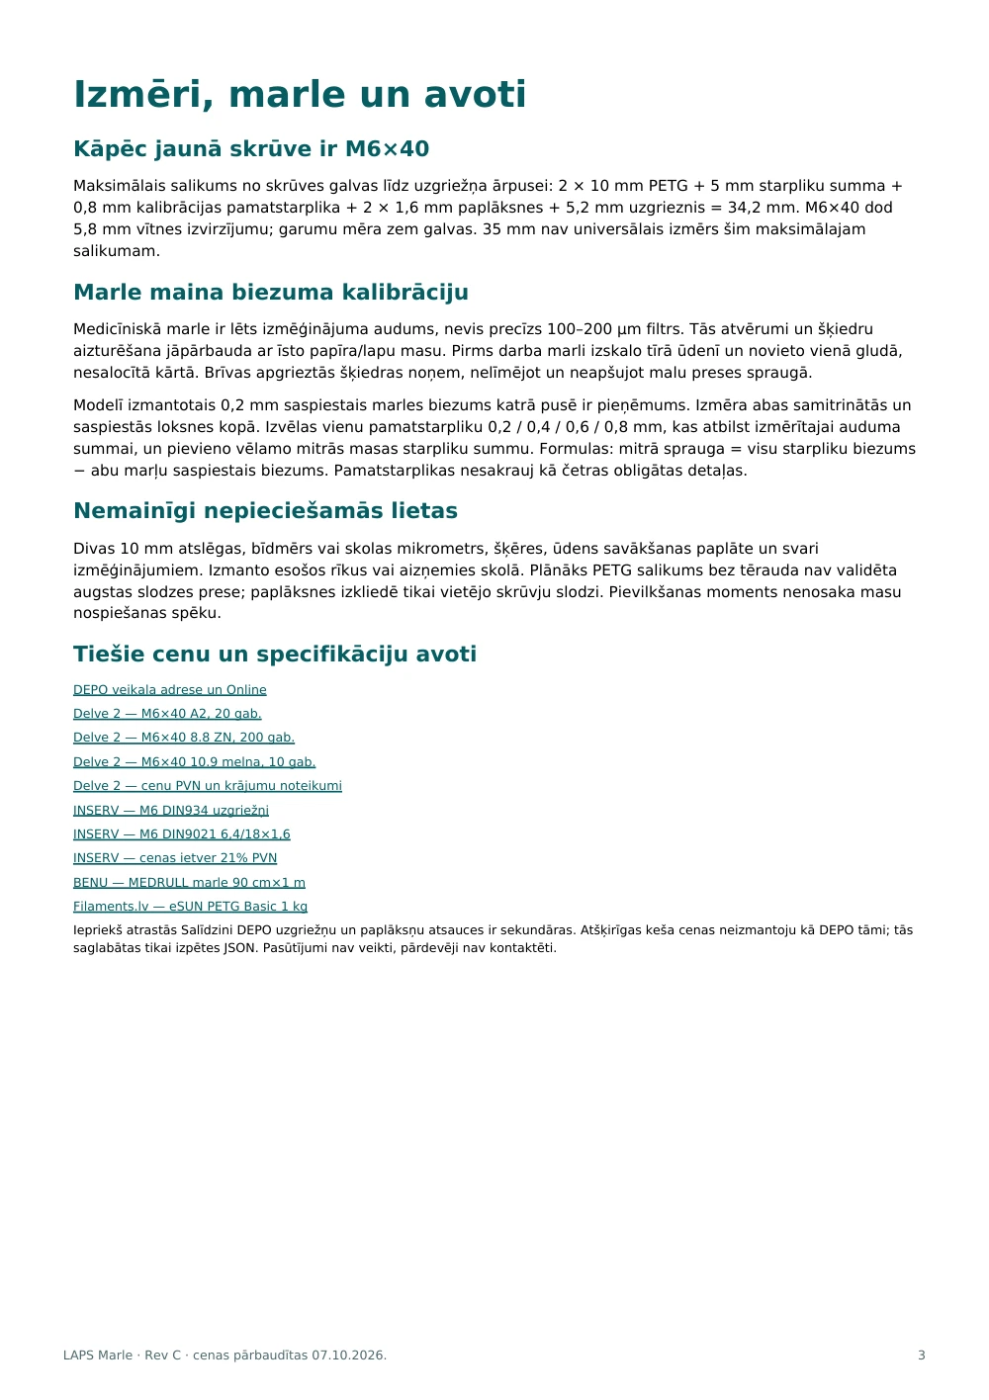
dist/laps-siets/documents/procurement-03.webp
