brantemadara-spec/laps/dist/podins/images/LAPS_Podins_Saliksana_01_sakotnejs.png

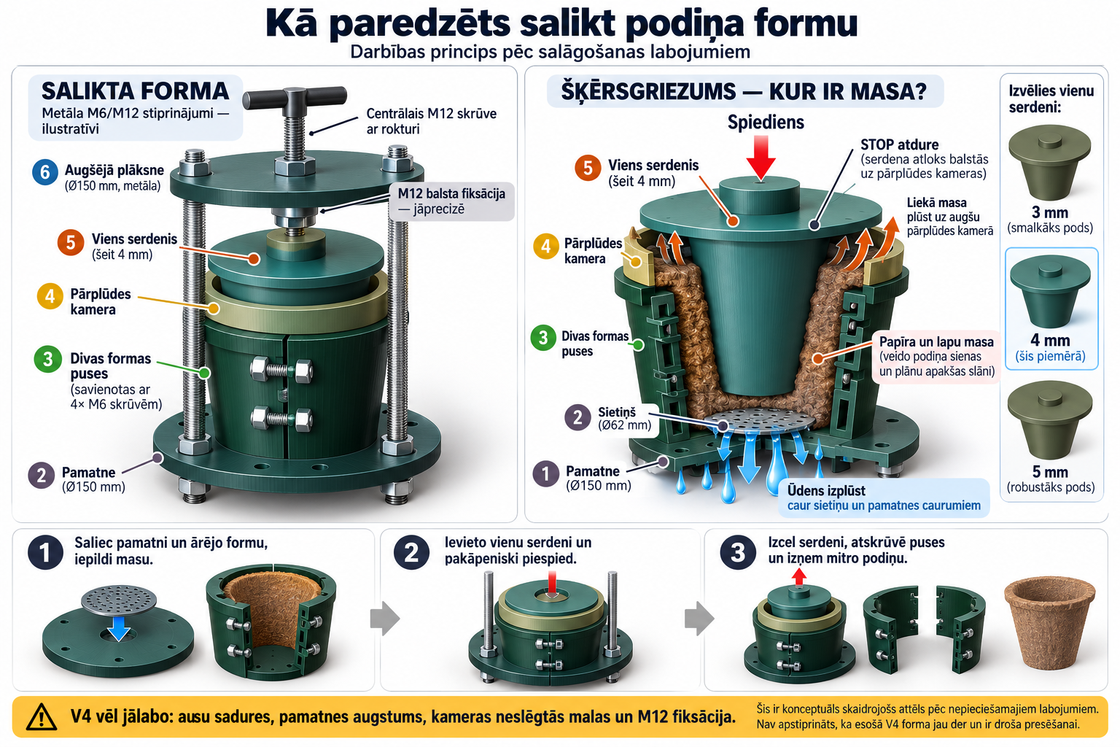
dist/podins/images/LAPS_Podins_Saliksana_01_sakotnejs.png
