brantemadara-spec/laps/dist/podins/images/V41_Austinas_45deg.png

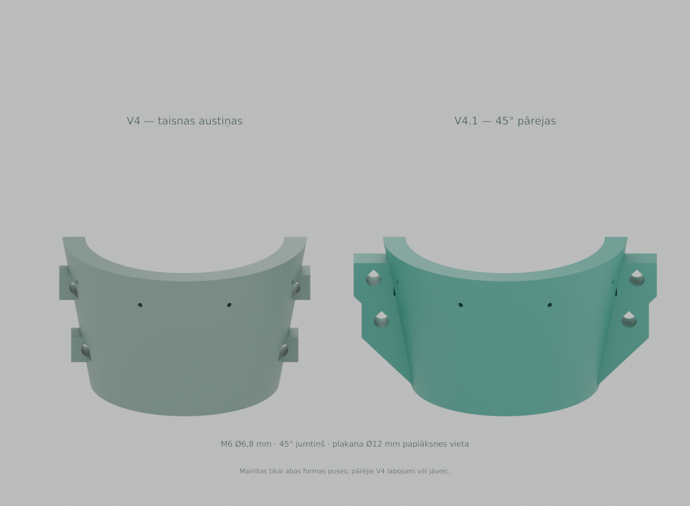
dist/podins/images/V41_Austinas_45deg.png
