brantemadara-spec/laps/assets/marle_source/cad/LAPS_Marle_assembled_3mm.step

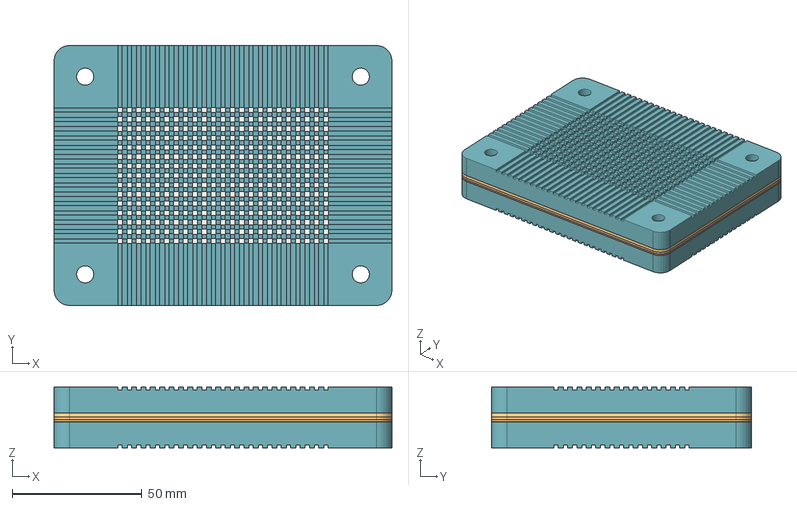
[picture p55: CAD file, 2026-11-09]
assets/marle_source/cad/LAPS_Marle_assembled_3mm.step
130.0 x 100.0 x 23.4 mm
lower_PETG_plate x 2
calibration_base_0p4_EXAMPLE
shim_0p5
shim_1p0
shim_1p5
lower_gauze_REFERENCE_NOT_FOR_PRINT x 2
wet_pulp_REFERENCE_NOT_FOR_PRINT
