brantemadara-spec/laps/assets/marle_source/cad/marle_shim_1.5mm_PRINT_2.step

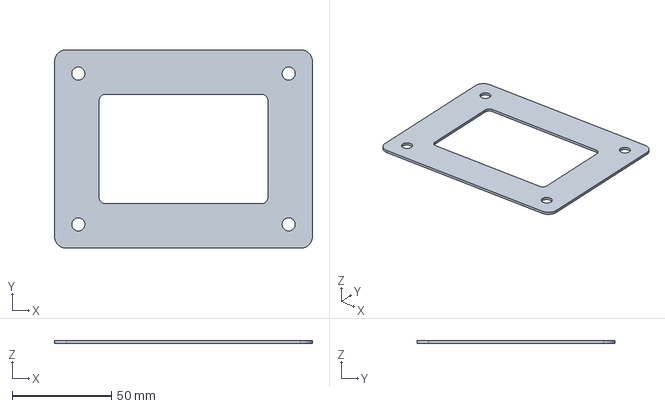
[picture p56: CAD file, 2026-11-09]
assets/marle_source/cad/marle_shim_1.5mm_PRINT_2.step
130.0 x 100.0 x 1.50 mm
