brantemadara-spec/laps/dist/podins/files/02_MOLD_RIGHT.stl

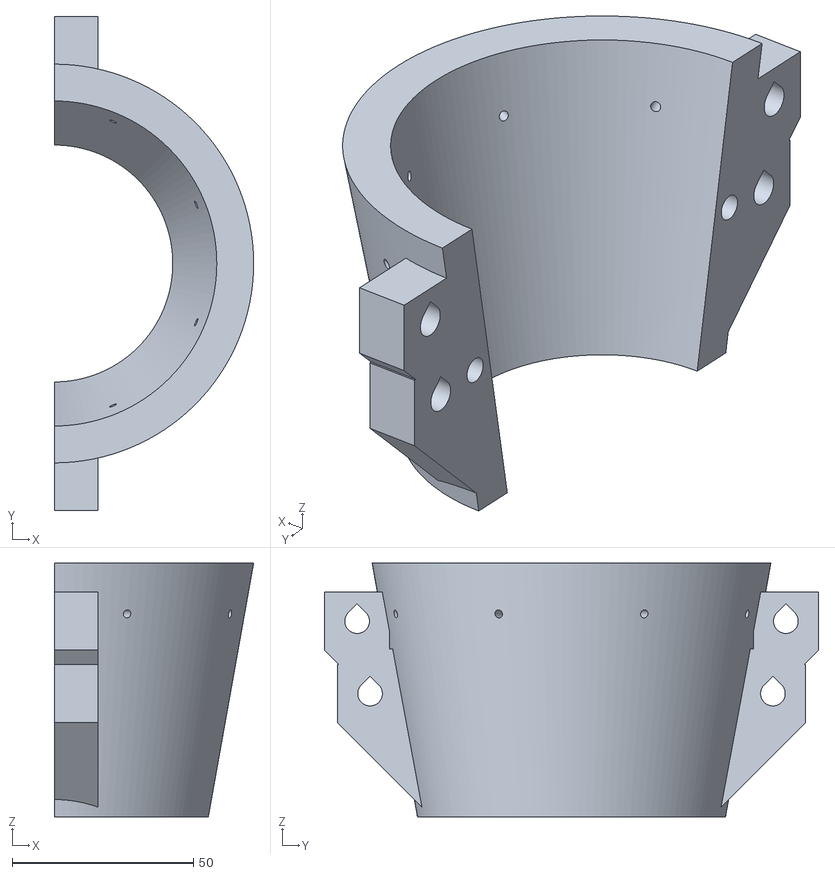
[picture p57: CAD file, 2026-11-09]
dist/podins/files/02_MOLD_RIGHT.stl
55.0 x 136.3 x 70.0
