brantemadara-spec/laps/assets/marle_source/cad/marle_base_0.2mm_PRINT_1.step

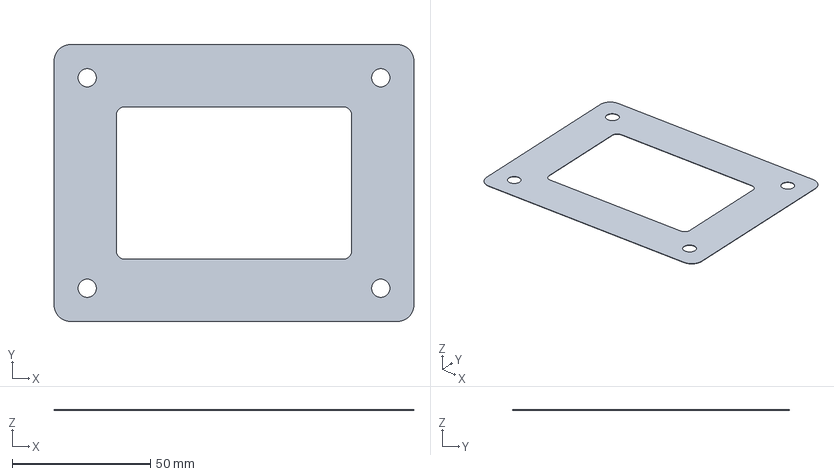
[picture p58: CAD file, 2026-11-09]
assets/marle_source/cad/marle_base_0.2mm_PRINT_1.step
130.0 x 100.0 x 0.2 mm
