brantemadara-spec/laps/dist/podins/files/01_MOLD_LEFT.stl

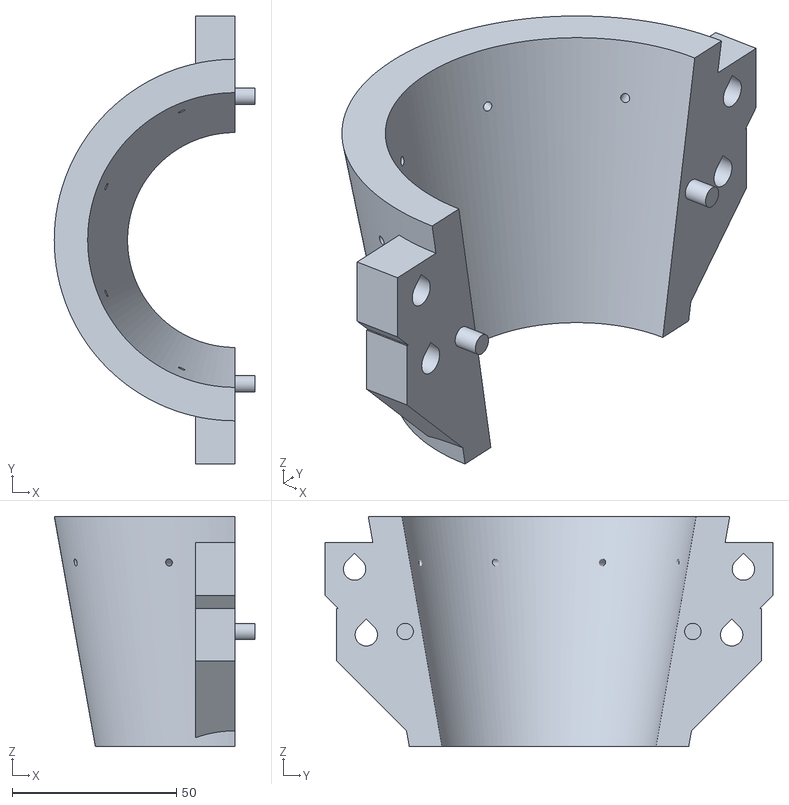
[picture p59: CAD file, 2026-11-09]
dist/podins/files/01_MOLD_LEFT.stl
61.0 x 136.3 x 70.0
