brantemadara-spec/laps/assets/marle_source/cad/marle_shim_1.0mm_PRINT_2.step

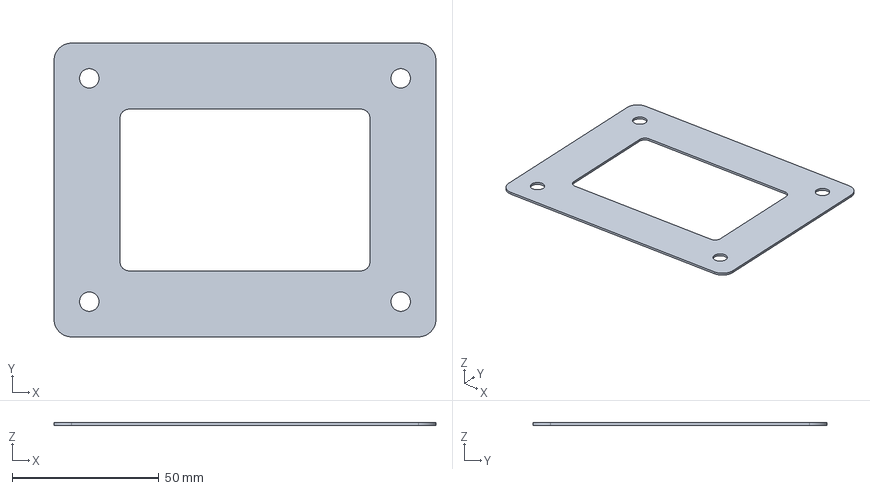
[picture p60: CAD file, 2026-11-09]
assets/marle_source/cad/marle_shim_1.0mm_PRINT_2.step
130.0 x 100.0 x 1.00 mm
