brantemadara-spec/laps/assets/marle_source/cad/marle_plate_PRINT_2.step

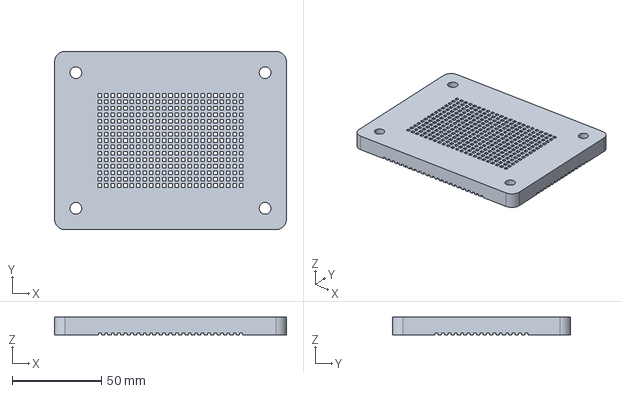
[picture p63: CAD file, 2026-11-09]
assets/marle_source/cad/marle_plate_PRINT_2.step
130.0 x 100.0 x 10.0 mm
