brantemadara-spec/laps/assets/marle_source/cad/marle_shim_0.5mm_PRINT_2.step

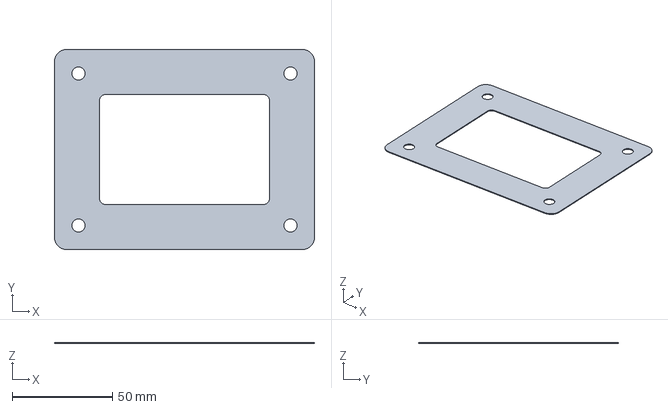
[picture p64: CAD file, 2026-11-09]
assets/marle_source/cad/marle_shim_0.5mm_PRINT_2.step
130.0 x 100.0 x 0.5 mm
