brantemadara-spec/laps/assets/marle_source/cad/marle_base_0.8mm_PRINT_1.step

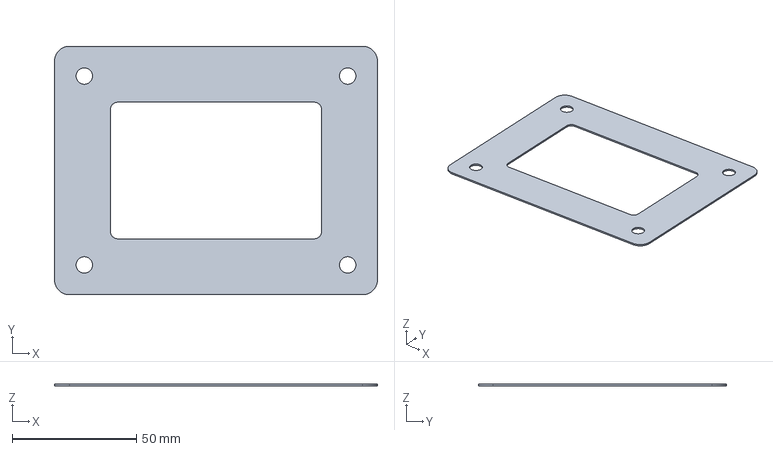
[picture p65: CAD file, 2026-11-09]
assets/marle_source/cad/marle_base_0.8mm_PRINT_1.step
130.0 x 100.0 x 0.8 mm
