brantemadara-spec/laps/(list of files, cad)

Other CAD files:
assets/marle_source/blender/LAPS_Marle_Prototips.blend
assets/marle_source/cad/marle_base_0.2mm_PRINT_1.stl
assets/marle_source/cad/marle_base_0.4mm_PRINT_1.stl
assets/marle_source/cad/marle_base_0.6mm_PRINT_1.stl
assets/marle_source/cad/marle_base_0.8mm_PRINT_1.stl
assets/marle_source/cad/marle_plate_PRINT_2.stl
assets/marle_source/cad/marle_shim_0.5mm_PRINT_2.stl
assets/marle_source/cad/marle_shim_1.0mm_PRINT_2.stl
assets/marle_source/cad/marle_shim_1.5mm_PRINT_2.stl
assets/marle_source/visual/LAPS_Marle.blend
dist/files/LAPS_Prototips.blend
dist/laps-siets/files/LAPS_Marle_Prototips.blend
dist/laps-siets/files/LAPS_Marle_Vizualizacija.blend
dist/podins/files/NO_KOKA_UZ_KOKU_Podina_prototips.blend
