brantemadara-spec/laps/assets/marle_source/visual/renders/02_exploded_assembly.png

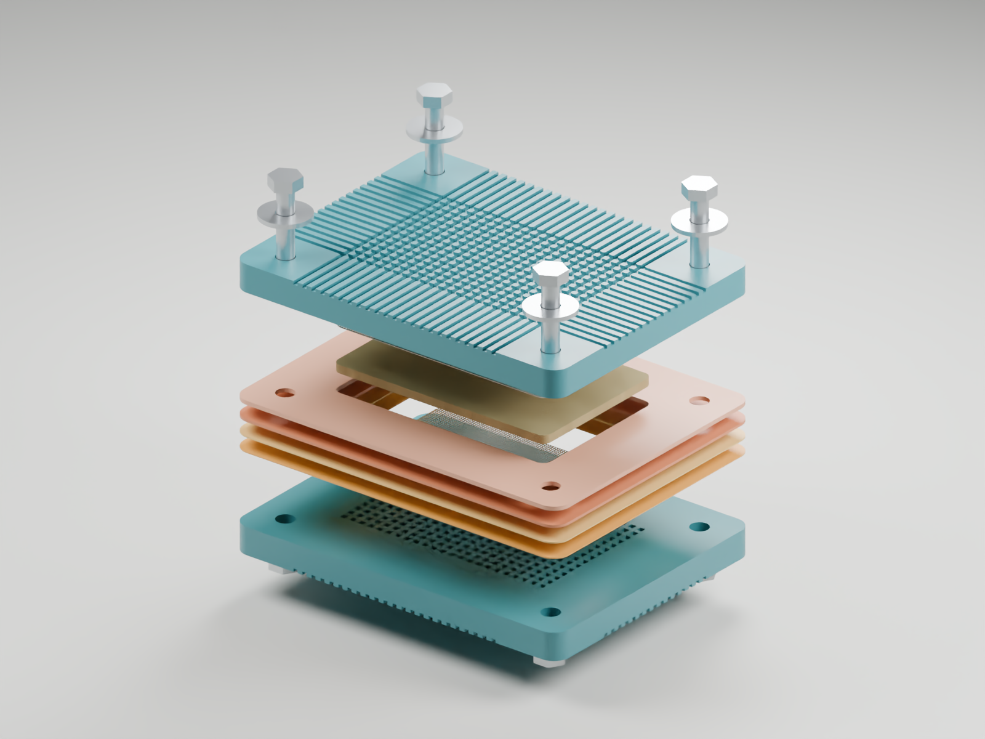
assets/marle_source/visual/renders/02_exploded_assembly.png
