brantemadara-spec/laps/assets/marle_source/visual/renders/05_assembled_side.png

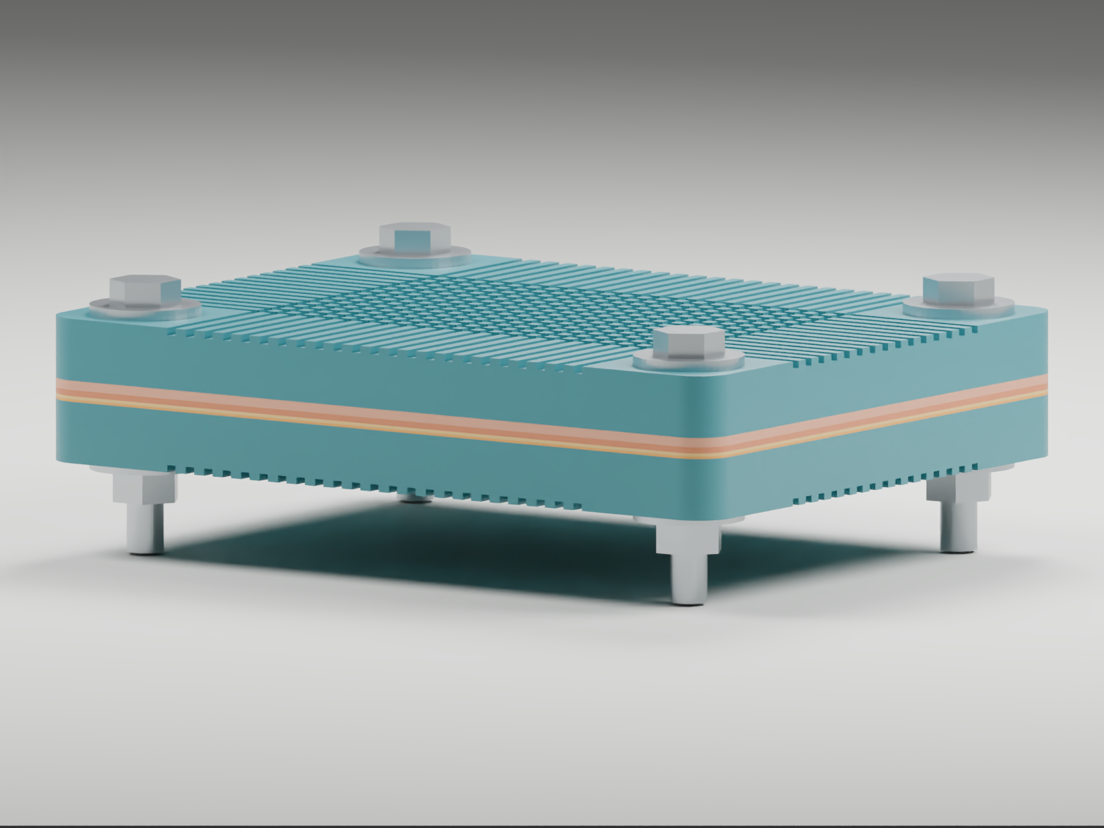
assets/marle_source/visual/renders/05_assembled_side.png
