brantemadara-spec/laps/dist/laps-siets/images/05_assembled_side.webp

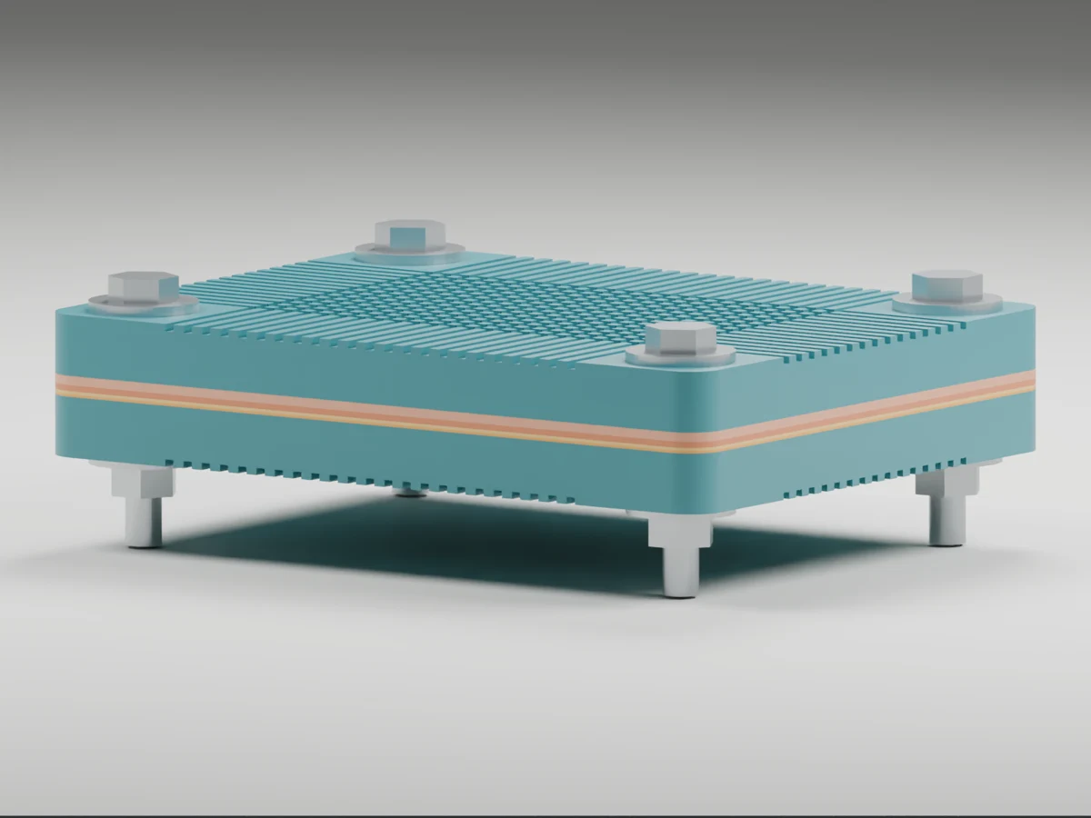
dist/laps-siets/images/05_assembled_side.webp
