brantemadara-spec/laps/assets/marle_source/visual/renders/04_all_calibration_bases_and_shims.png

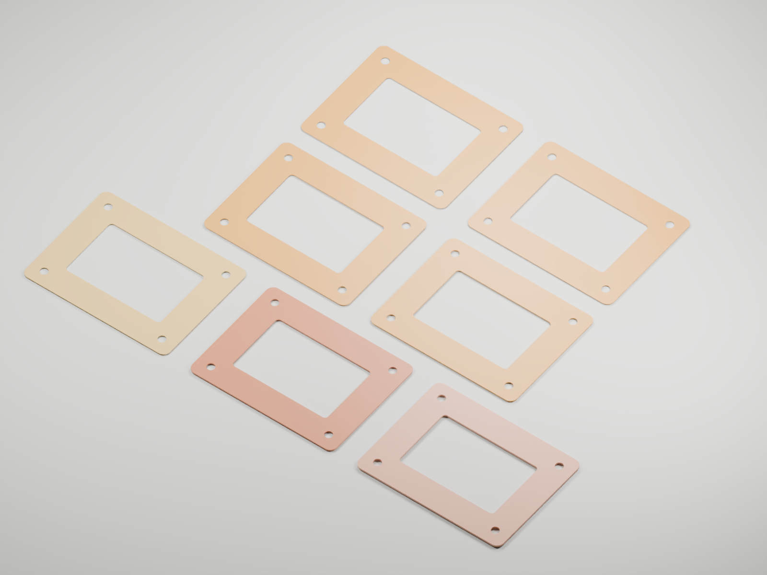
assets/marle_source/visual/renders/04_all_calibration_bases_and_shims.png
